rupc/synthesizer/README.md

## 동기
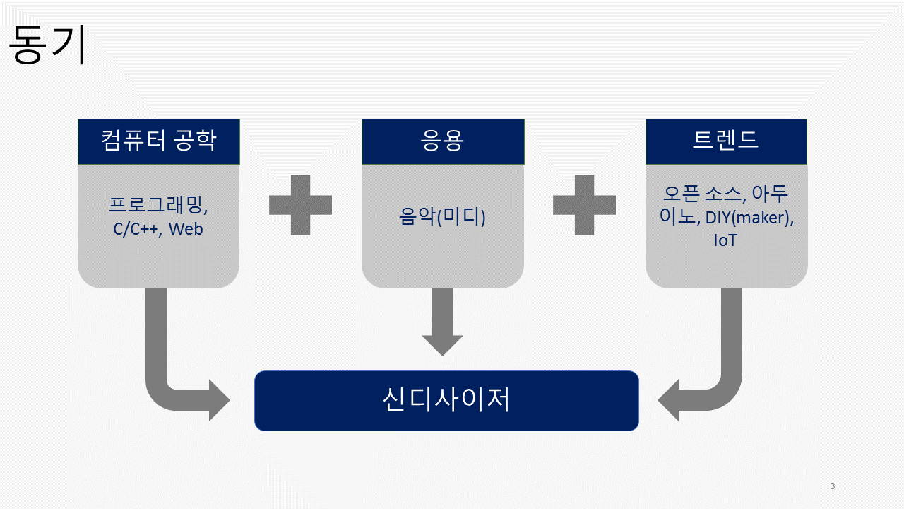
[picture p1: pics/slide3.PNG]


## 시스템 구성
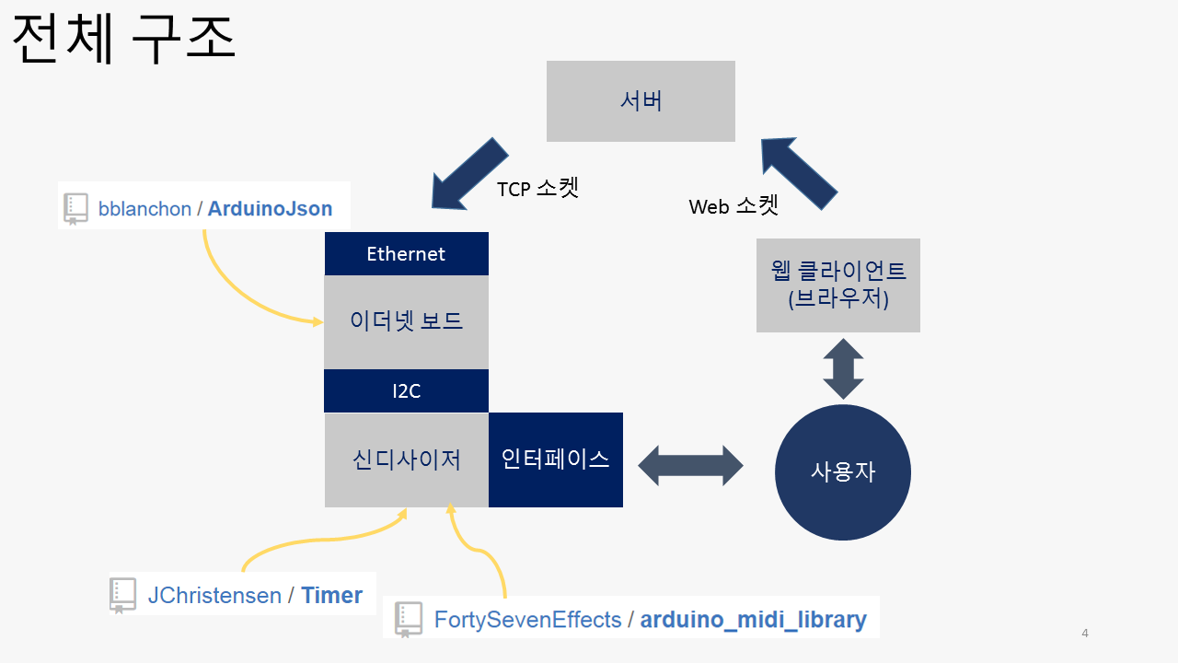
[picture p2: pics/슬라이드4.PNG]


## 신다사이저의 구성
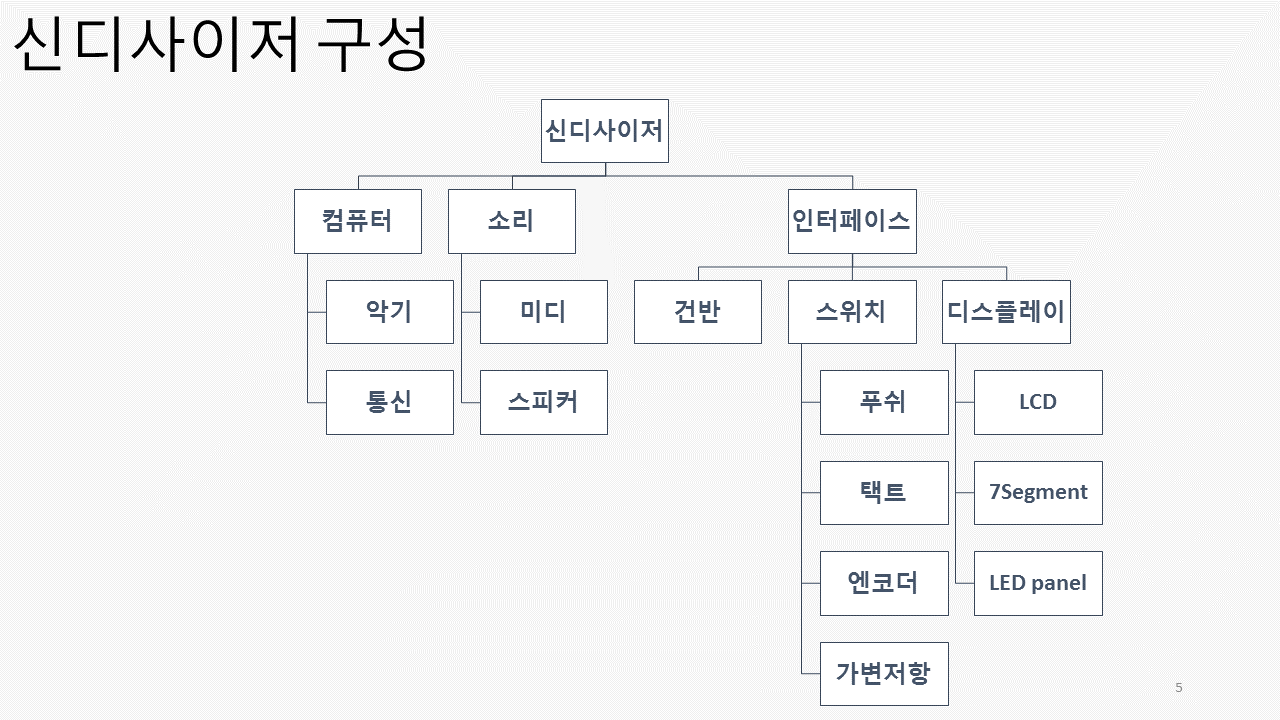
[picture p3: pics/슬라이드5.PNG]


## 기술 세부사항
### 하드웨어
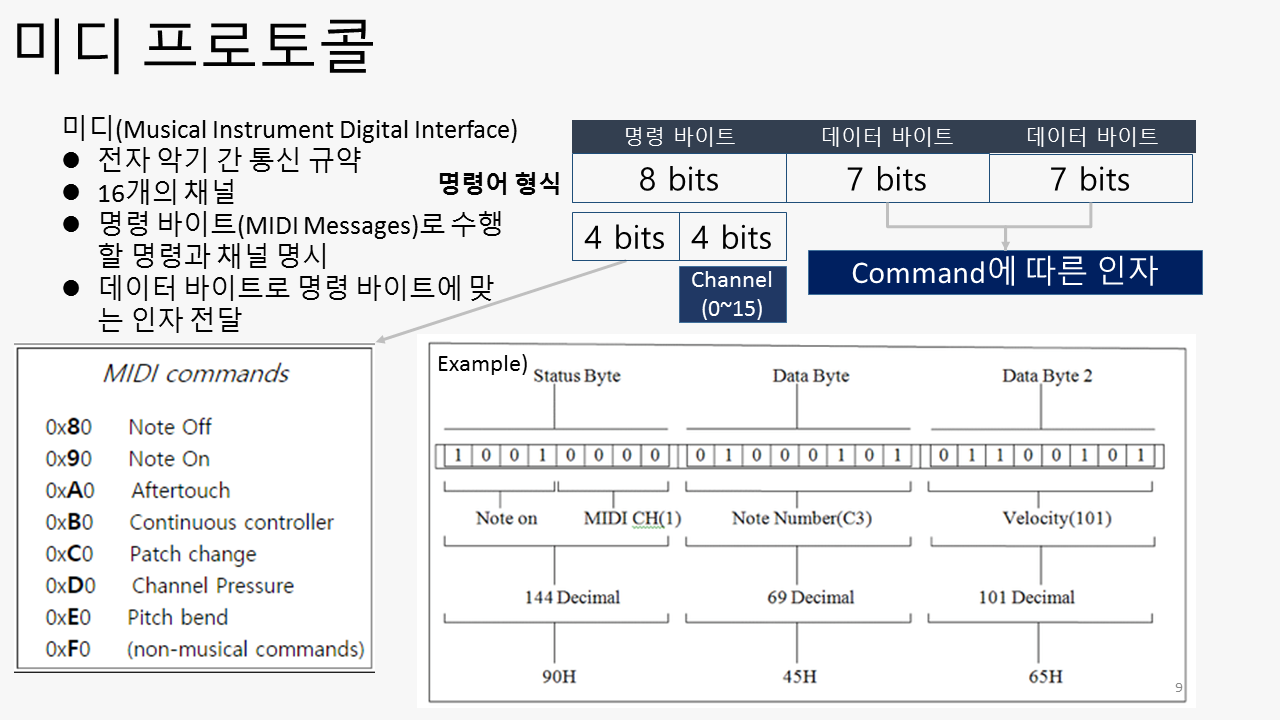
[picture p4: pics/슬라이드9.PNG]

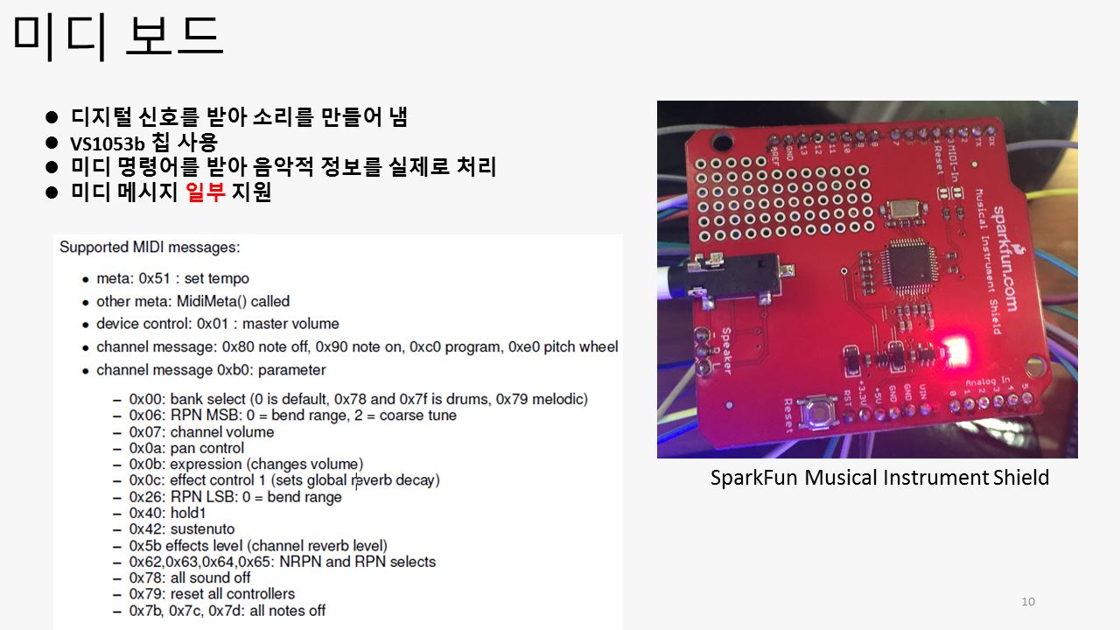
[picture p5: pics/슬라이드10.PNG]

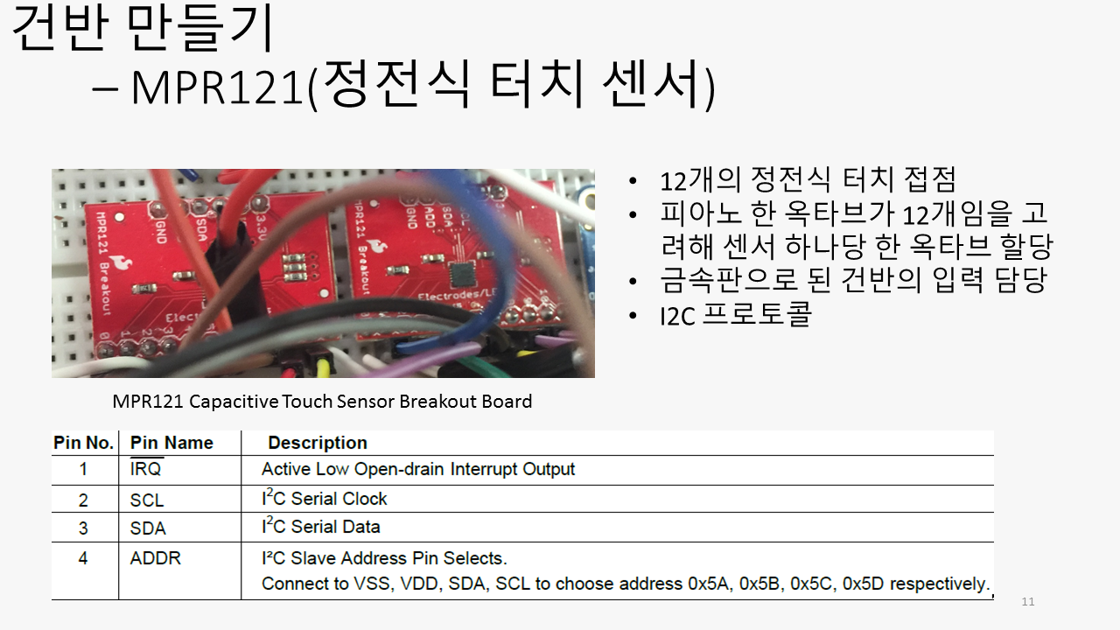
[picture p6: pics/슬라이드11.PNG]

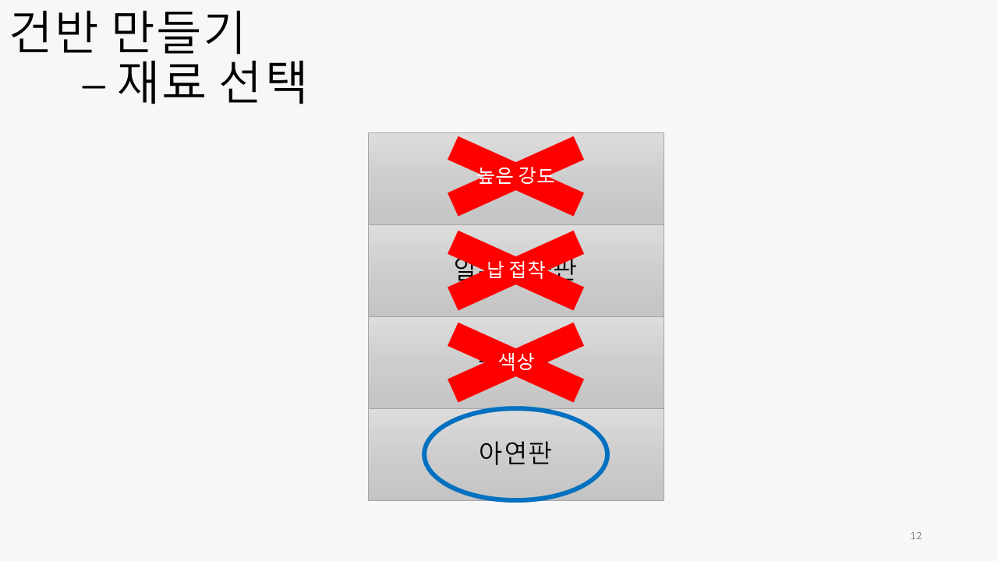
[picture p7: pics/슬라이드12.PNG]

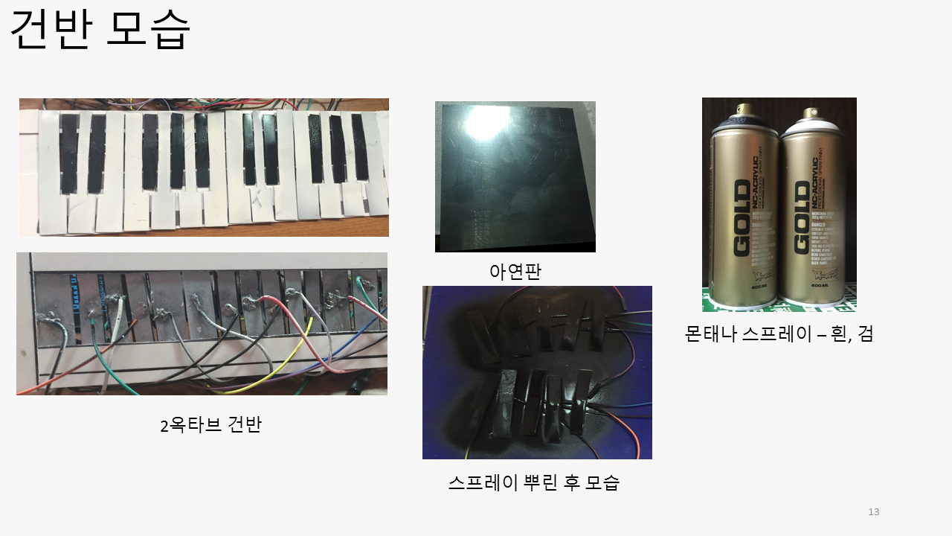
[picture p8: pics/슬라이드13.PNG]

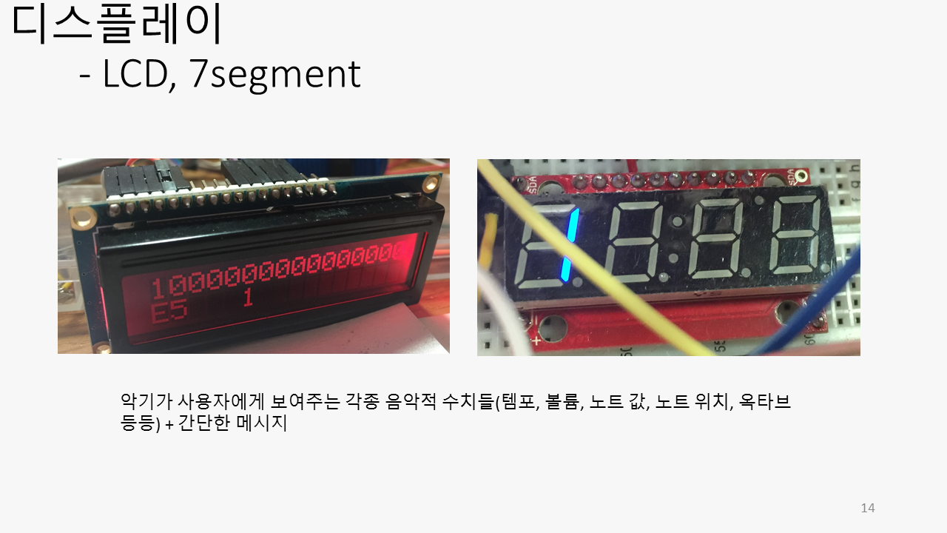
[picture p9: pics/슬라이드14.PNG]

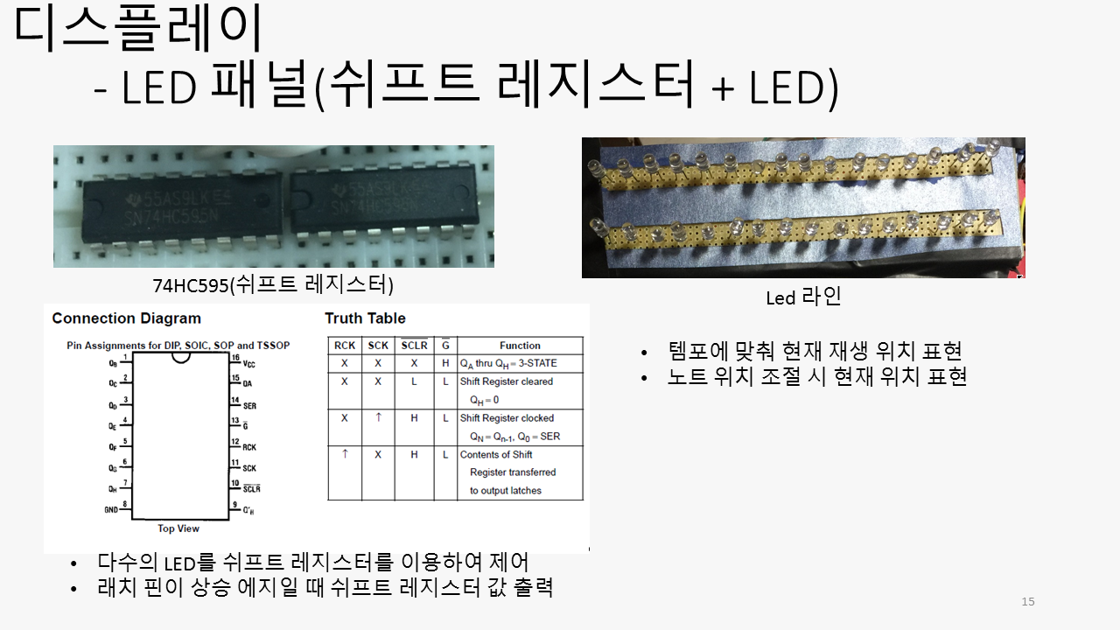
[picture p10: pics/슬라이드15.PNG]

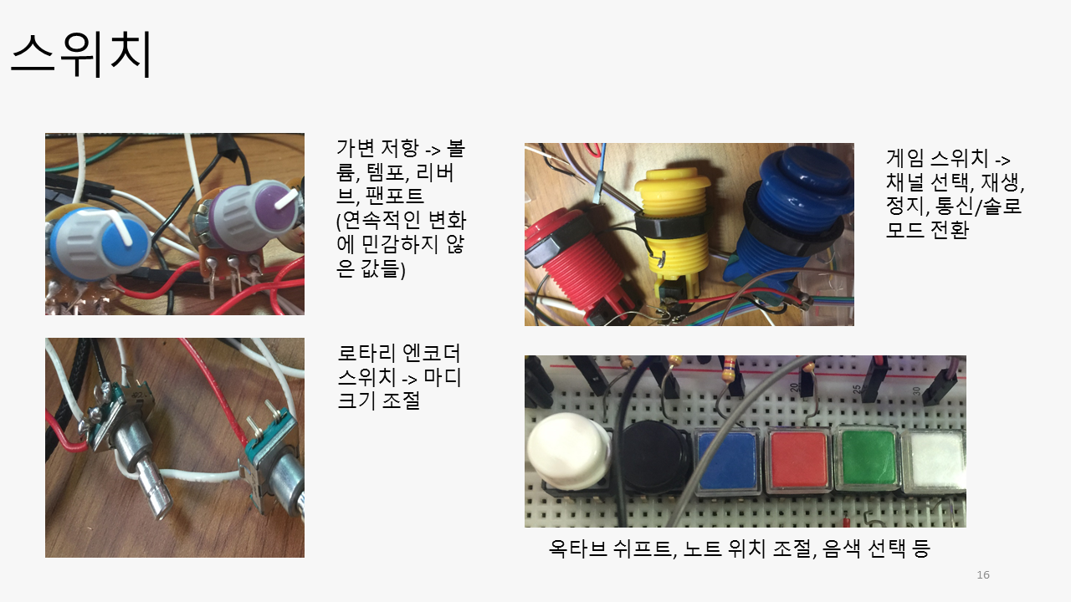
[picture p11: pics/슬라이드16.PNG]

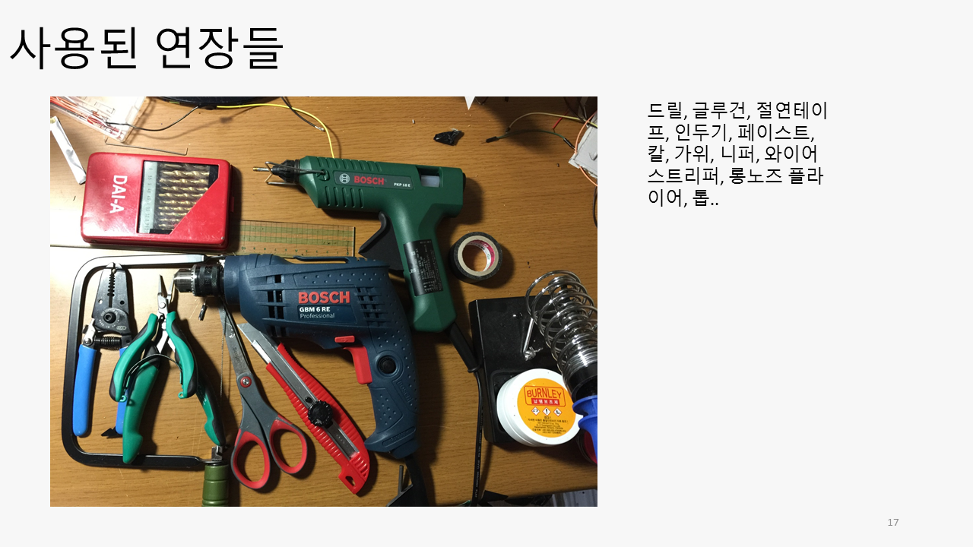
[picture p12: pics/슬라이드17.PNG]


### 소프트웨어
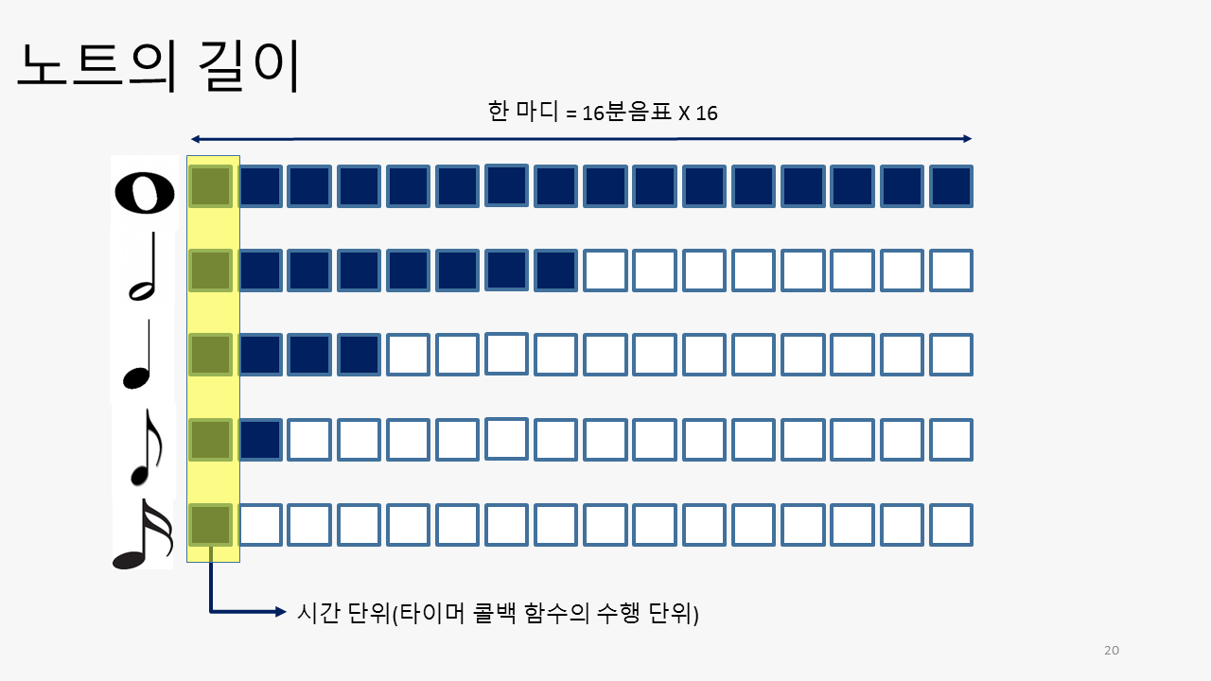
[picture p13: pics/슬라이드20.PNG]

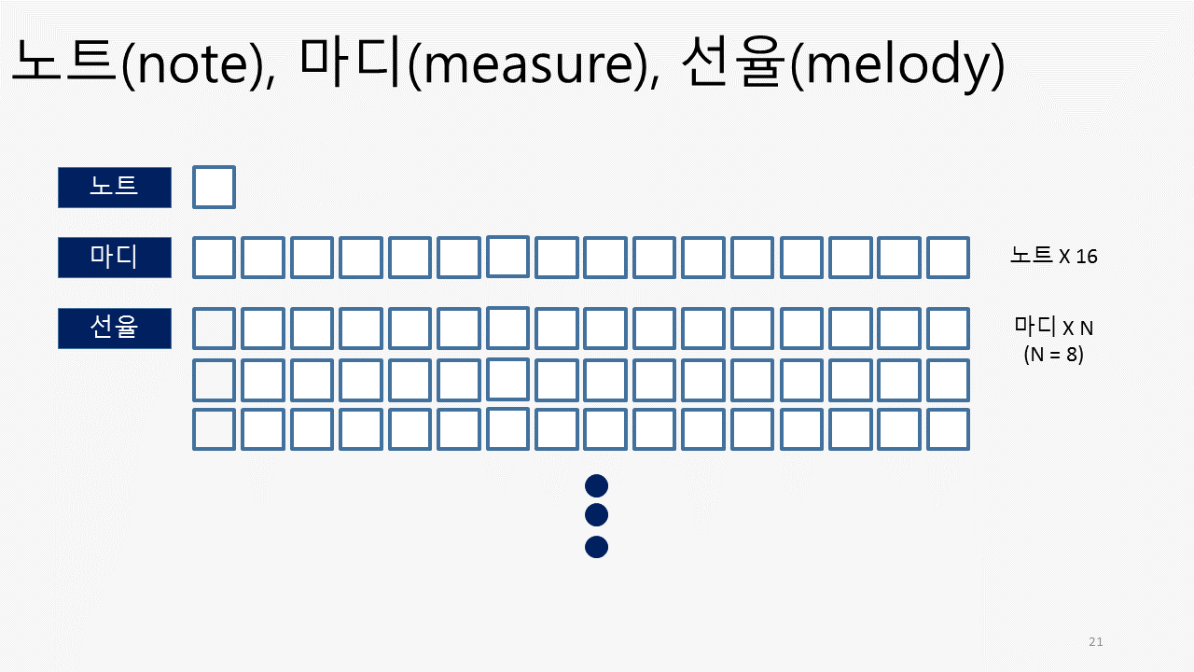
[picture p14: pics/슬라이드21.PNG]

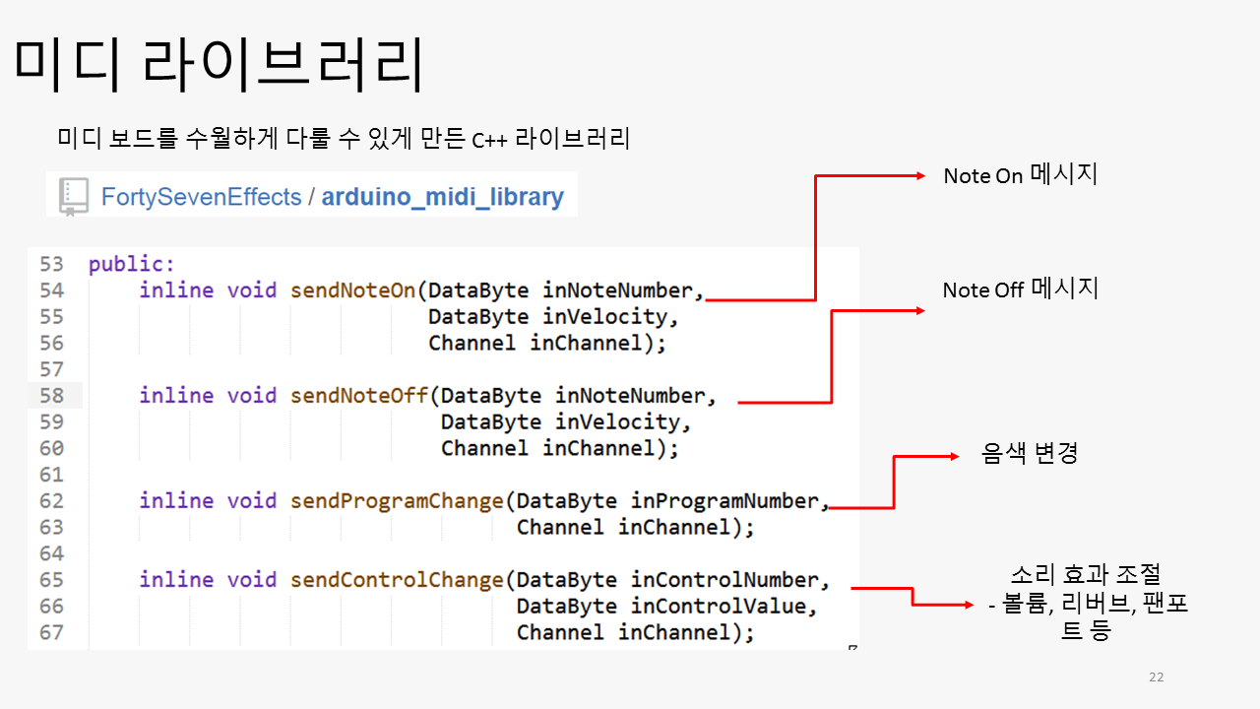
[picture p15: pics/슬라이드22.PNG]

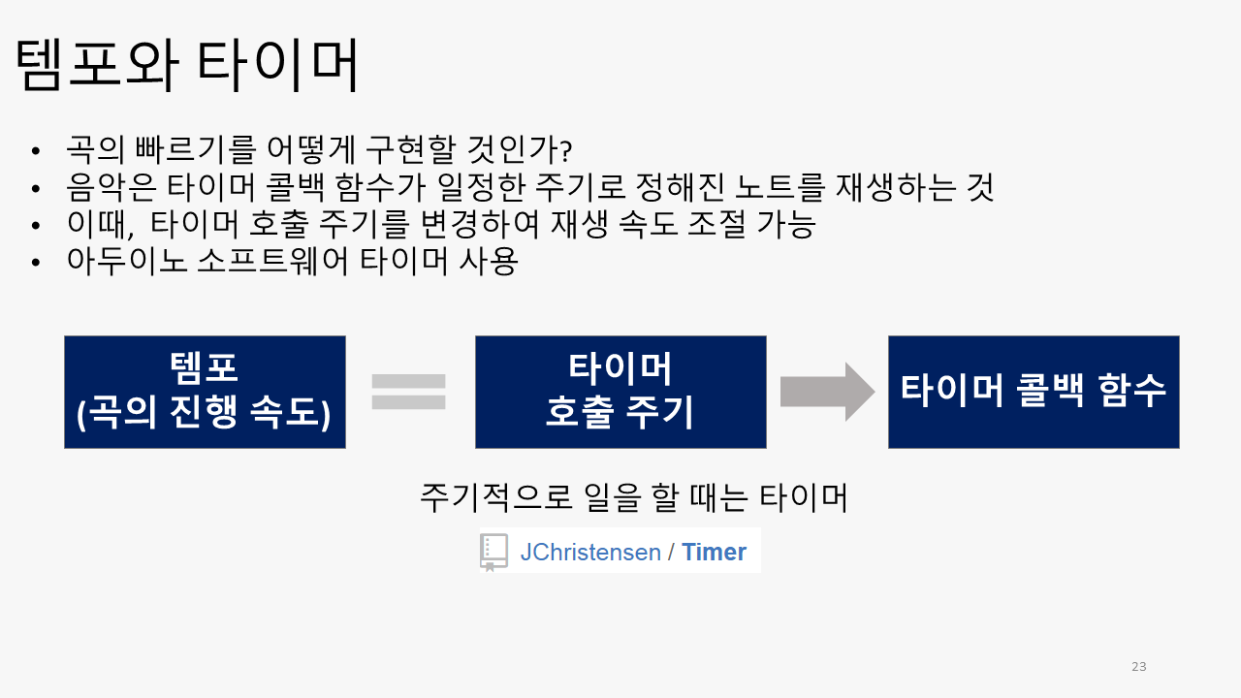
[picture p16: pics/슬라이드23.PNG]

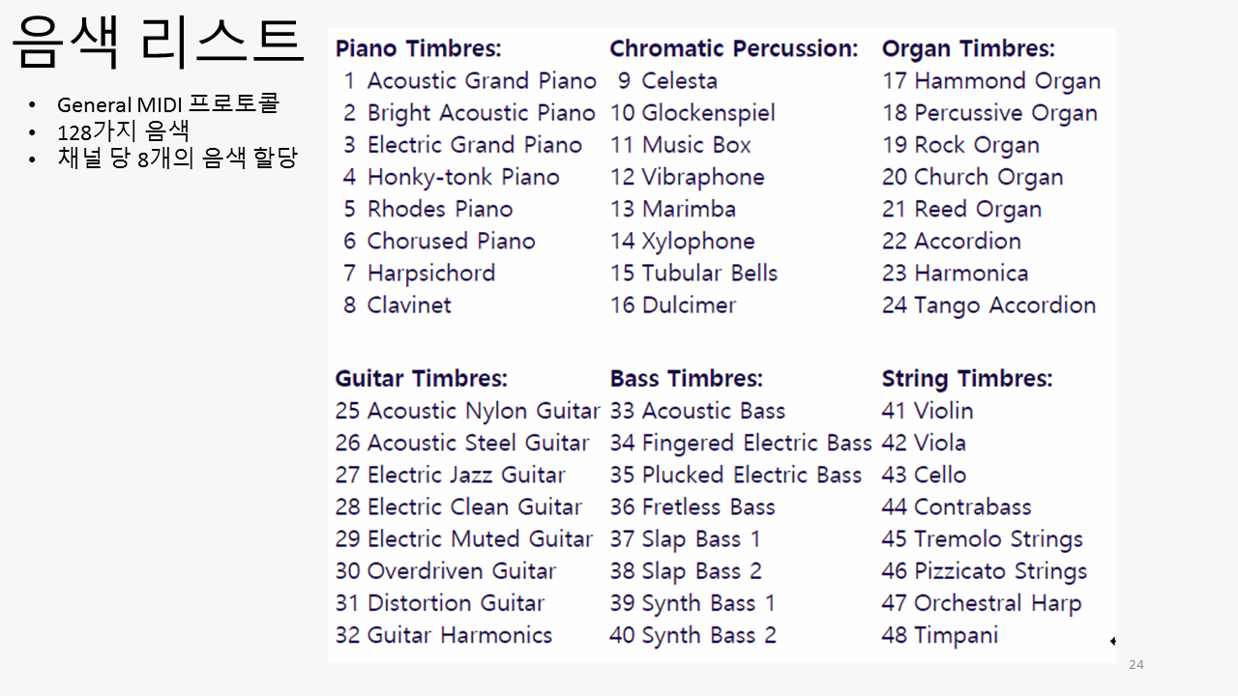
[picture p17: pics/슬라이드24.PNG]

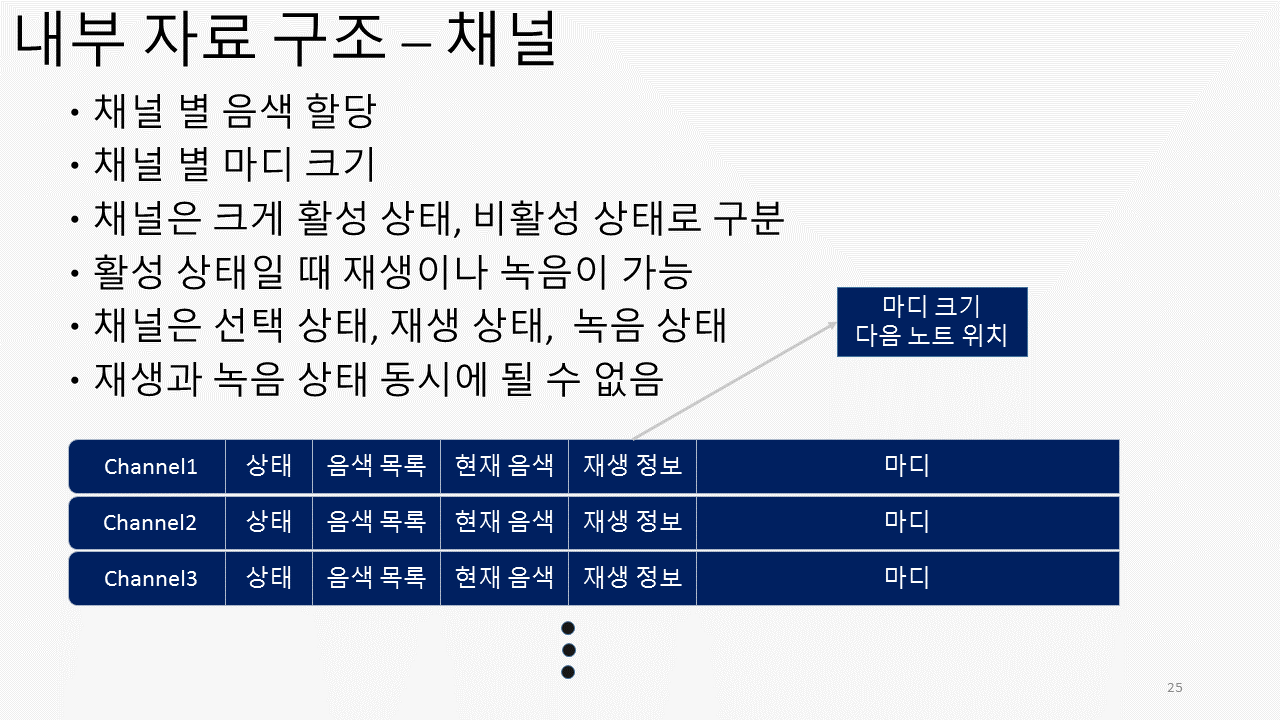
[picture p18: pics/슬라이드25.PNG]

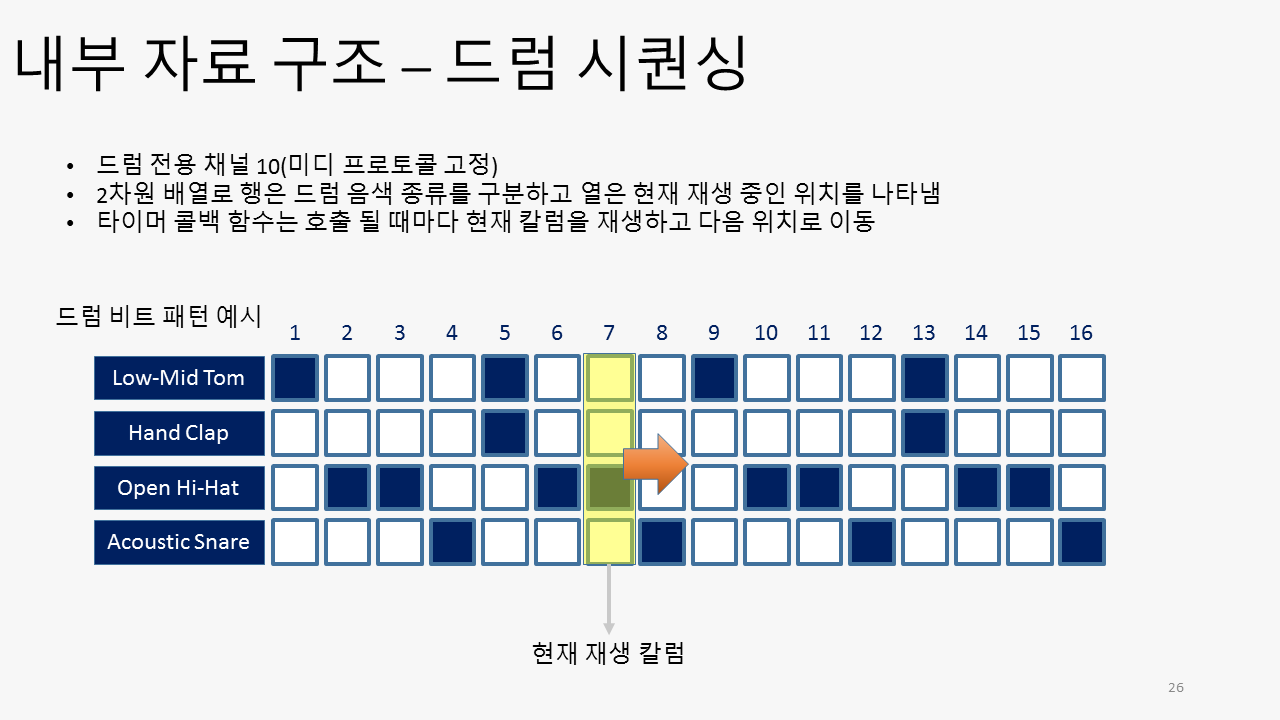
[picture p19: pics/슬라이드26.PNG]


### 기능
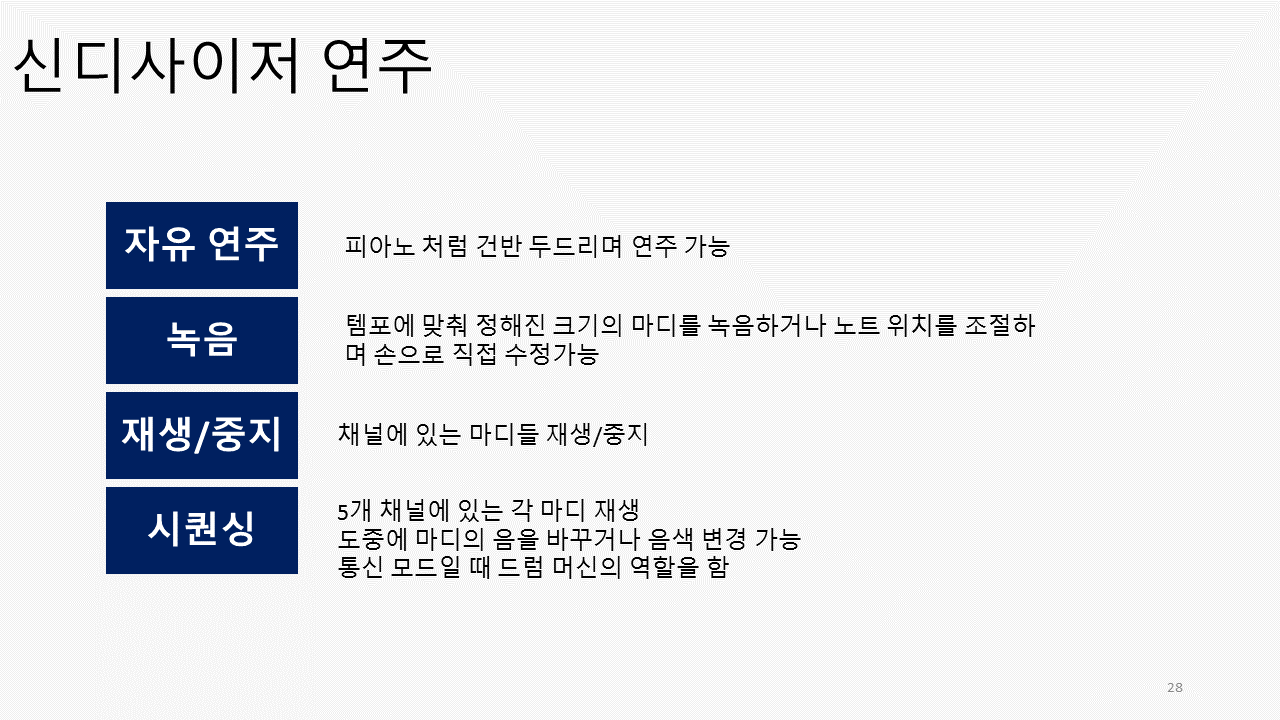
[picture p20: pics/슬라이드28.PNG]

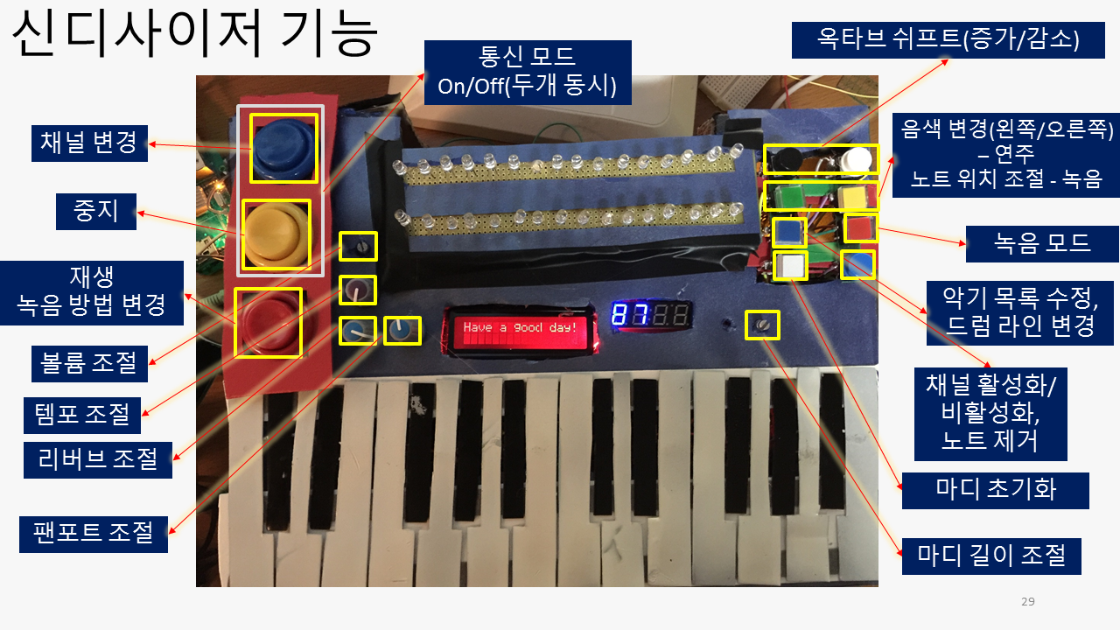
[picture p21: pics/슬라이드29.PNG]


## 영상
[기본 연주](https://www.youtube.com/watch?v=AMejLA61EGs)
[웹 기반 연주](https://www.youtube.com/watch?v=s74J_ezt0MM)
