rupc/synthesizer/docs/2015졸업과제-발표자료(하프시코드).pdf

# 신디사이저와 IoT

### 하프시코드 201224540 조용래

목차

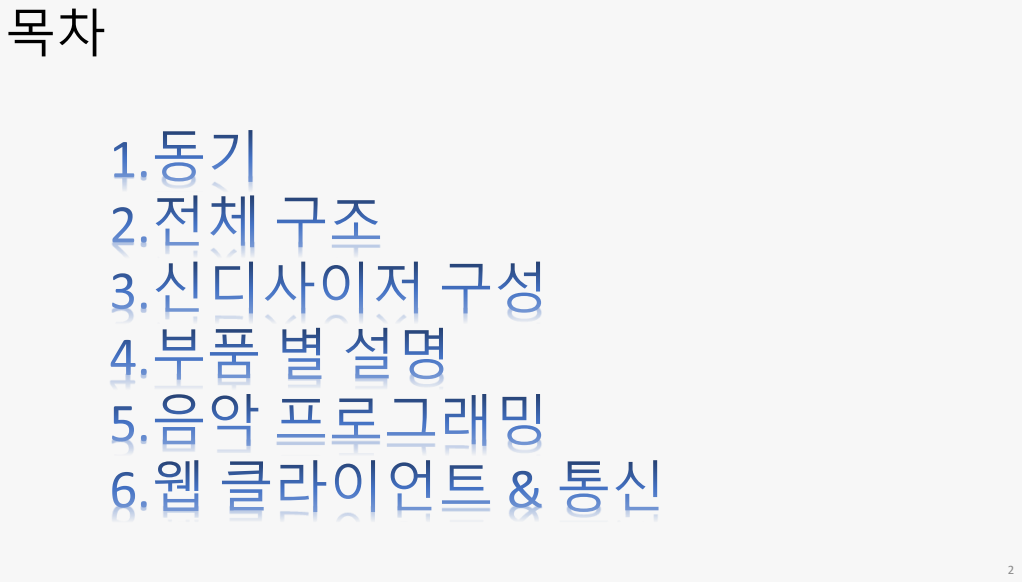
[picture p55: page 2]

동기

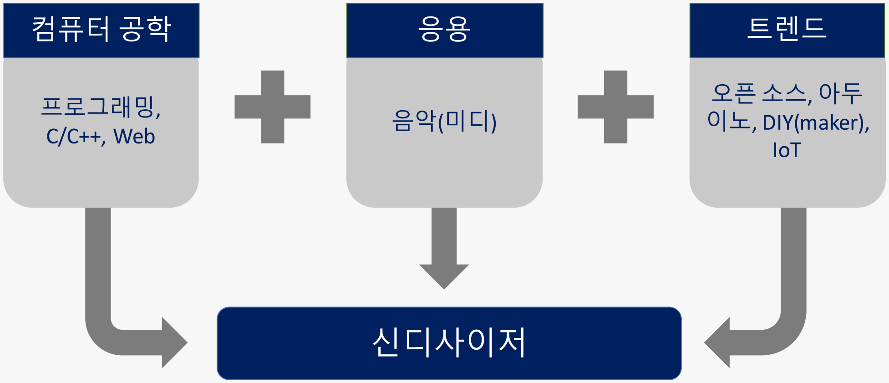
[picture p56: figure]
프로그래밍, C/C++, Web; 컴퓨터 공학; 오픈 소스, 아두 이노, DIY(maker), IoT; 트렌드; 신디사이저

# 전체 구조

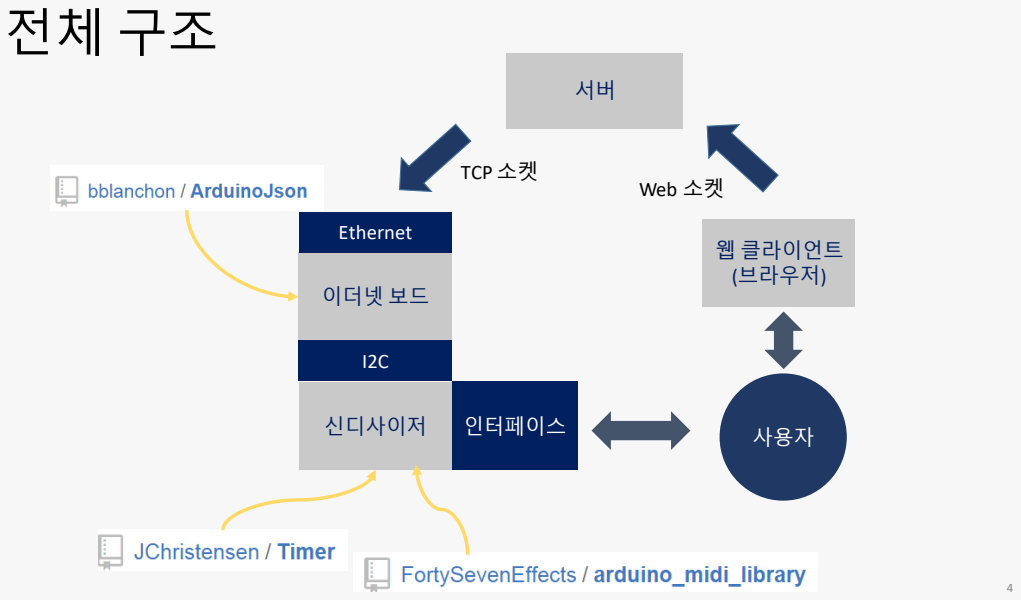
[picture p57: page 4]
TCP 소켓; Web 소켓; 웹 클라이언트 (브라우저); 이더넷 보드; 신디사이저; 인터페이스; 사용자; Ethernet

# 신디사이저 구성

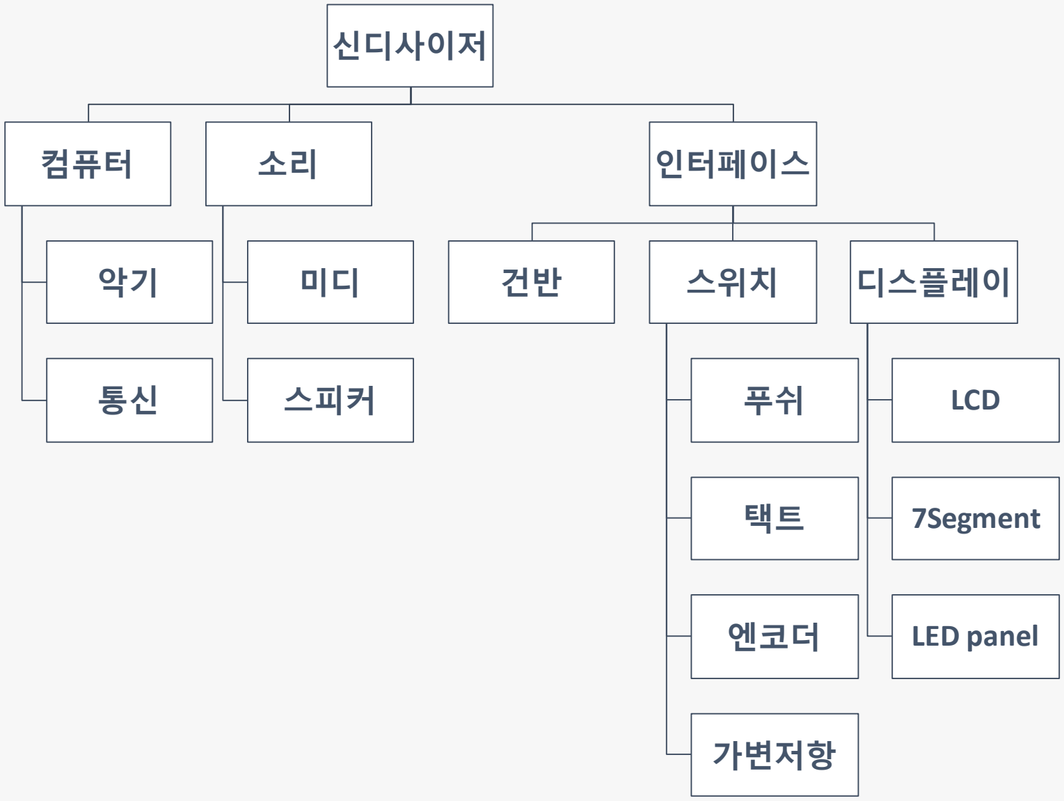
[picture p58: figure]
신디사이저; 컴퓨터; 스피커; 인터페이스; 스위치; 엔코더; 가변저항; 디스플레이; LCD; 7Segment; LED panel

# 신디사이저 전체 사진

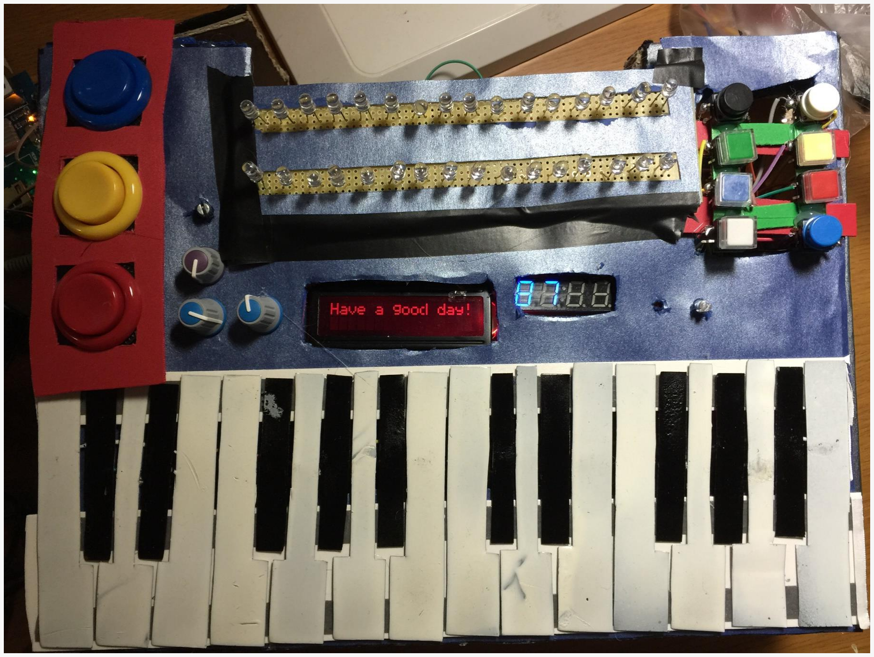
[picture p59: figure]

# 부품 별 설명

# 마이크로컨트롤러

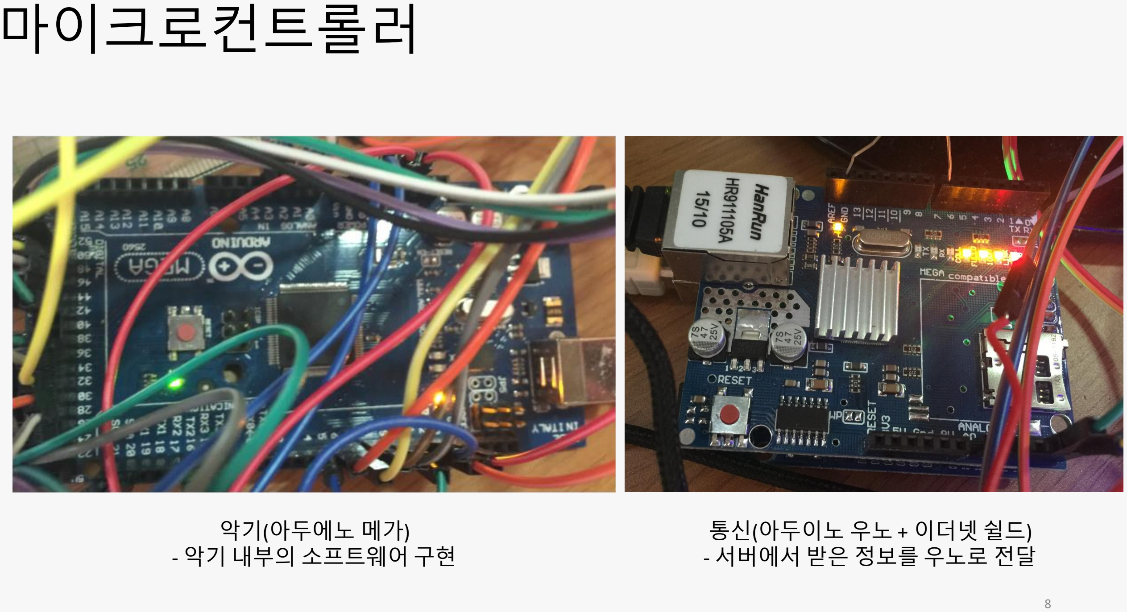
[picture p60: page 8]

통신(아두이노 우노 + 이더넷 쉴드)
- 서버에서 받은 정보를 우노로 전달

악기(아두에노 메가)
- 악기 내부의 소프트웨어 구현

# 미디 프로토콜

8 bits | 7 bits | 7 bits

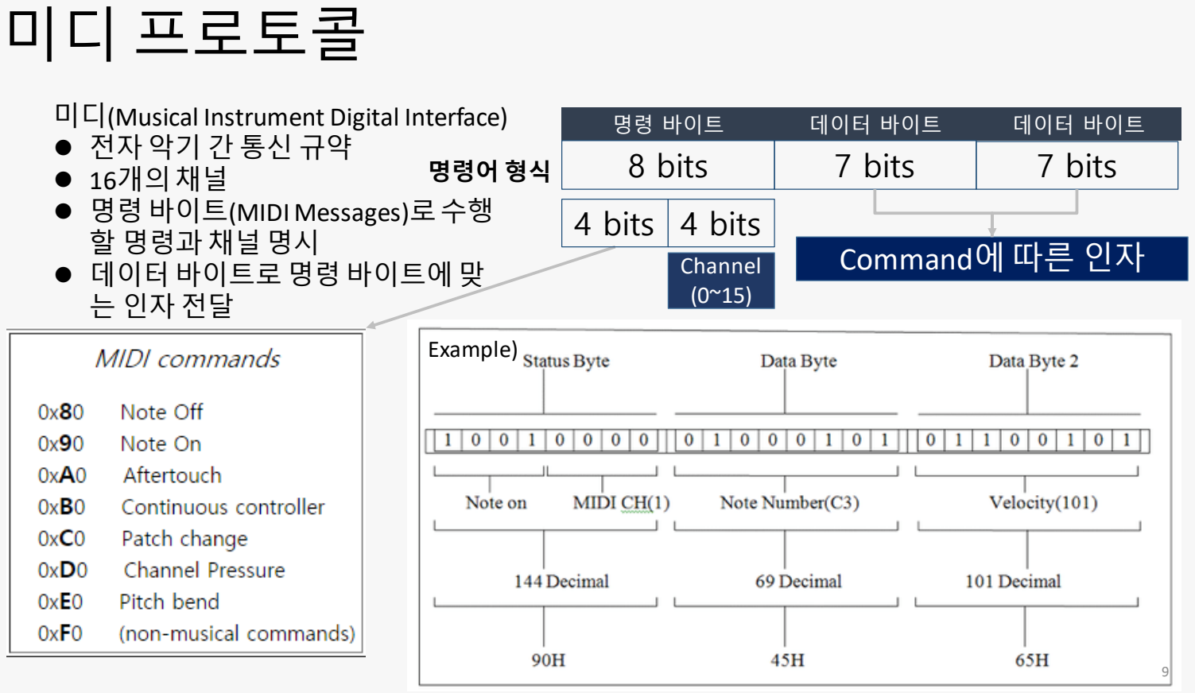
[picture p61: page 9]

미디(Musical Instrument Digital Interface)
- 전자 악기 간 통신 규약
- 16개의채널
- 명령 바이트(MIDI Messages)로수행 할 명령과 채널 명시
- 데이터 바이트로 명령 바이트에 맞
는 인자 전달

명령어 형식

명령 바이트 | 데이터 바이트 | 데이터 바이트
4 bits | 4 bits Channel (0~15)

### Command에 따른 인자

Example)

# 미디 보드

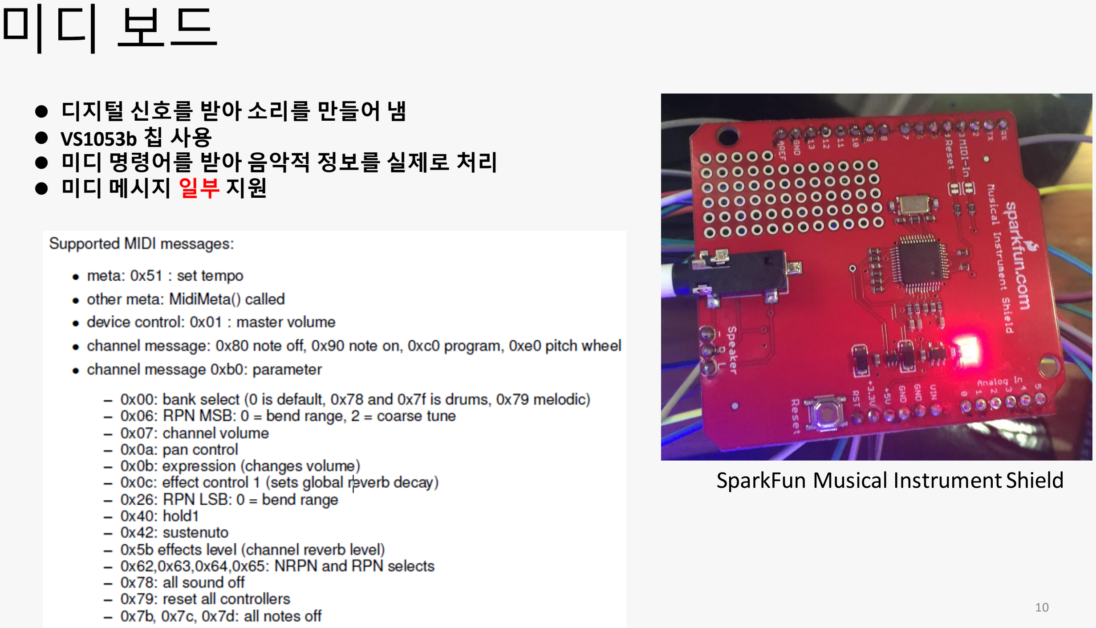
[picture p62: page 10]

- 디지털 신호를 받아 소리를 만들어 냄
- VS1053b 칩 사용
- 미디 명령어를 받아 음악적 정보를 실제로 처리
- 미디 메시지 일부 지원

SparkFun Musical Instrument Shield

# 건반 만들기

# – MPR121(정전식 터치 센서)

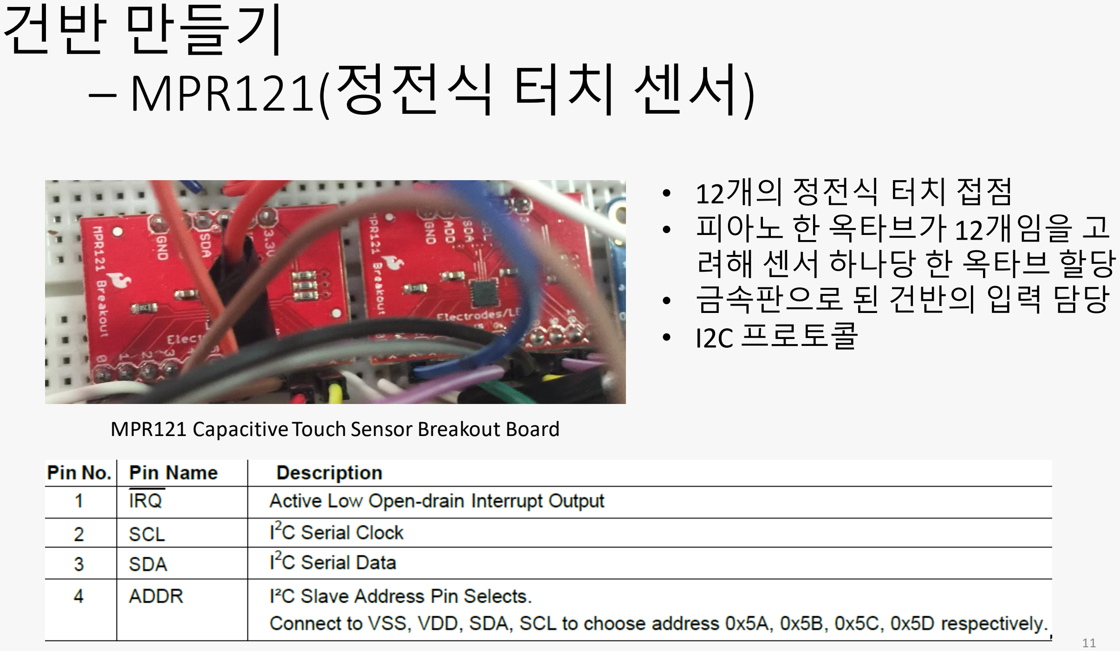
[picture p63: page 11]

## - 12개의 정전식 터치 접점 - 피아노 한 옥타브가 12개임을 고 려해 센서 하나당 한 옥타브 할당 - 금속판으로 된 건반의 입력 담당

### - I2C 프로토콜

MPR121 Capacitive Touch Sensor Breakout Board

# 건반 만들기 – 재료 선택

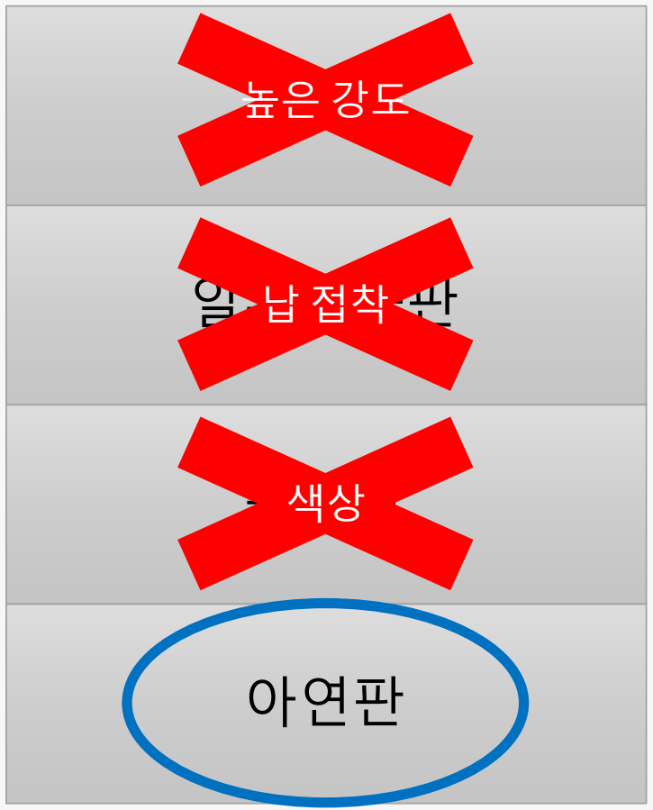
[picture p64: figure]
알루미늄판; 구리판; 아연판

# 건반 모습

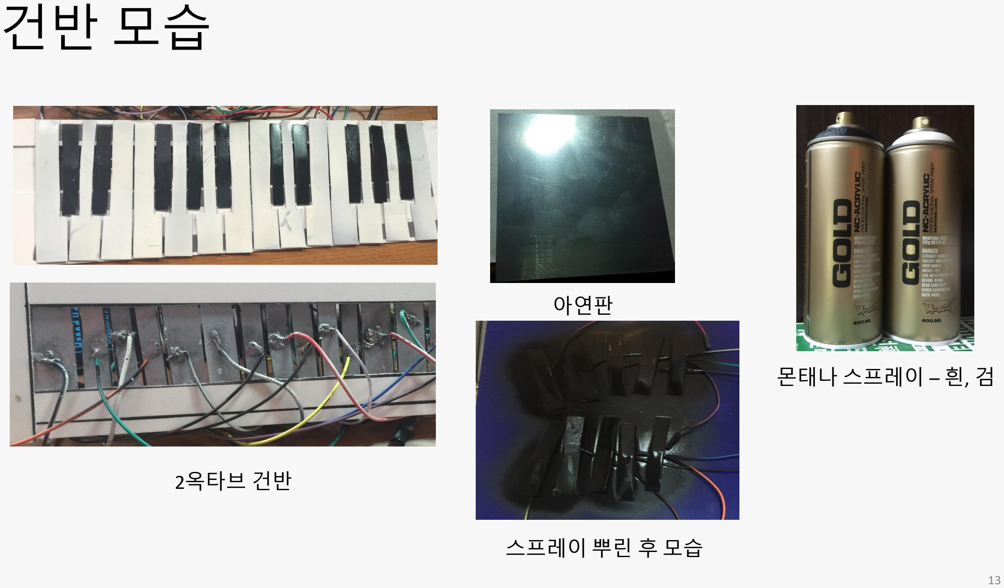
[picture p65: page 13]

몬태나 스프레이 – 흰, 검

아연판

2옥타브 건반

스프레이 뿌린 후 모습

# 디스플레이

# - LCD, 7segment

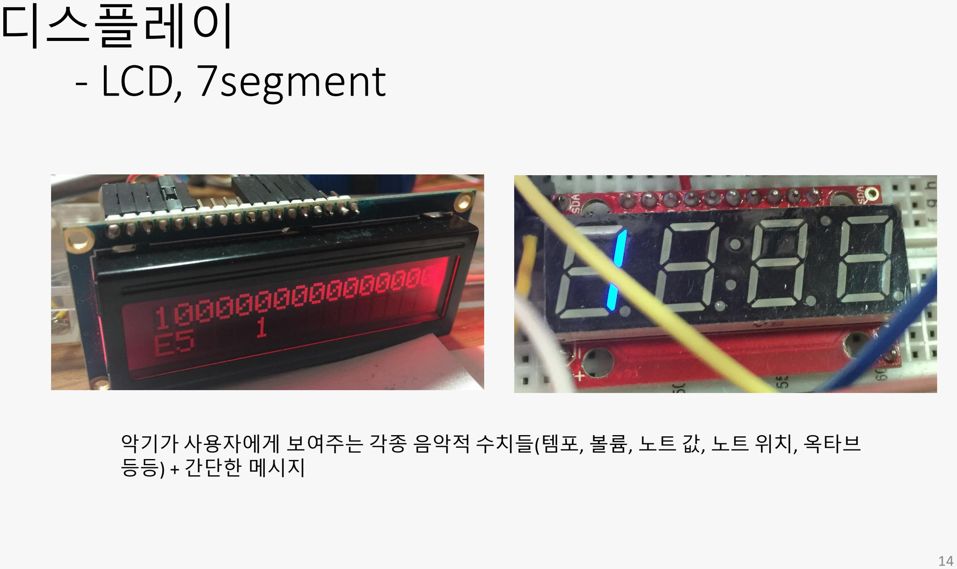
[picture p66: page 14]

악기가 사용자에게 보여주는 각종 음악적 수치들(템포, 볼륨, 노트 값, 노트 위치, 옥타브 등등) + 간단한 메시지

# 디스플레이

# - LED 패널(쉬프트 레지스터 + LED)

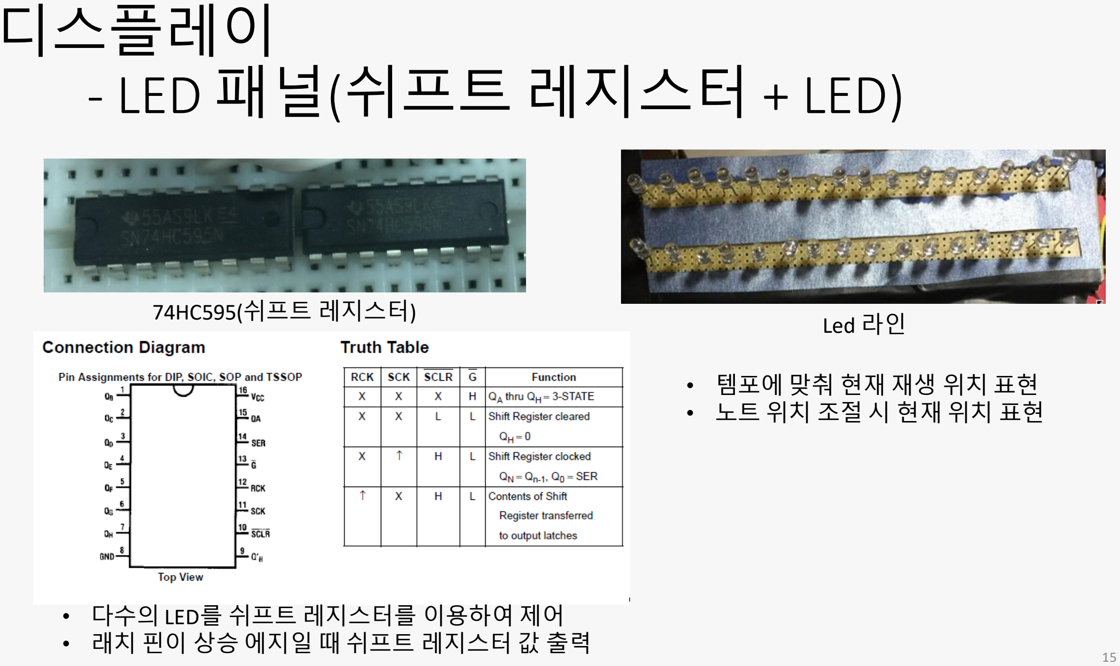
[picture p67: page 15]

- 다수의 LED를 쉬프트 레지스터를 이용하여 제어
- 래치 핀이 상승 에지일 때 쉬프트 레지스터 값 출력
- 템포에 맞춰 현재 재생 위치 표현
- 노트 위치 조절 시 현재 위치 표현

74HC595(쉬프트 레지스터)
Led 라인

# 스위치

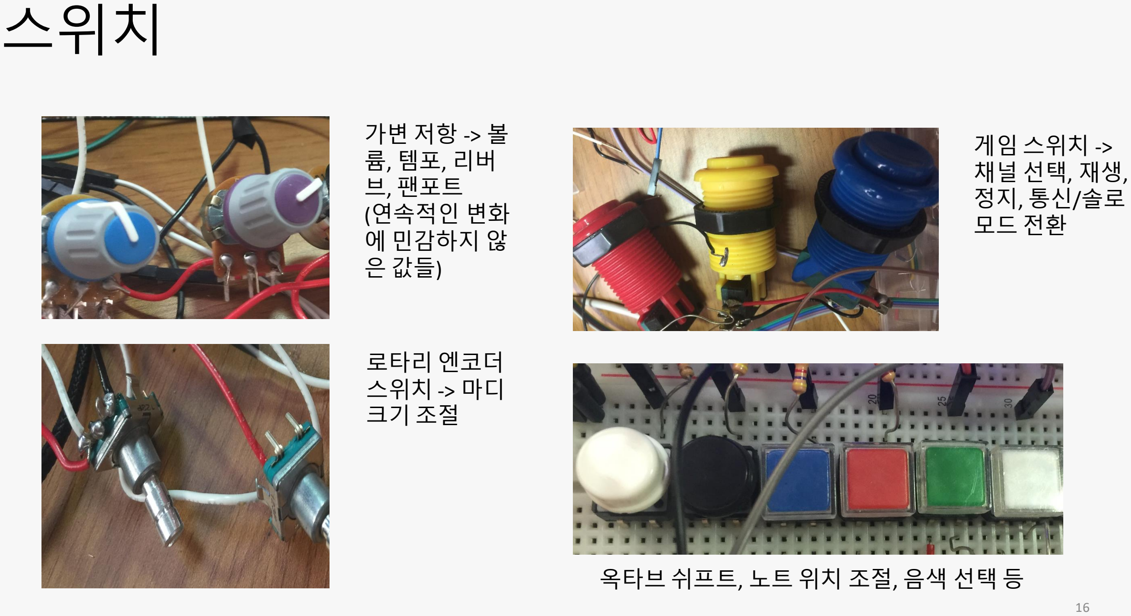
[picture p68: page 16]

가변 저항 -> 볼
륨, 템포, 리버
브, 팬포트
(연속적인 변화
에 민감하지 않
은 값들)

게임 스위치 ->
채널 선택, 재생,
정지, 통신/솔로
모드 전환

로타리 엔코더
스위치 -> 마디
크기 조절

옥타브 쉬프트, 노트 위치 조절, 음색 선택 등

# 사용된 연장들

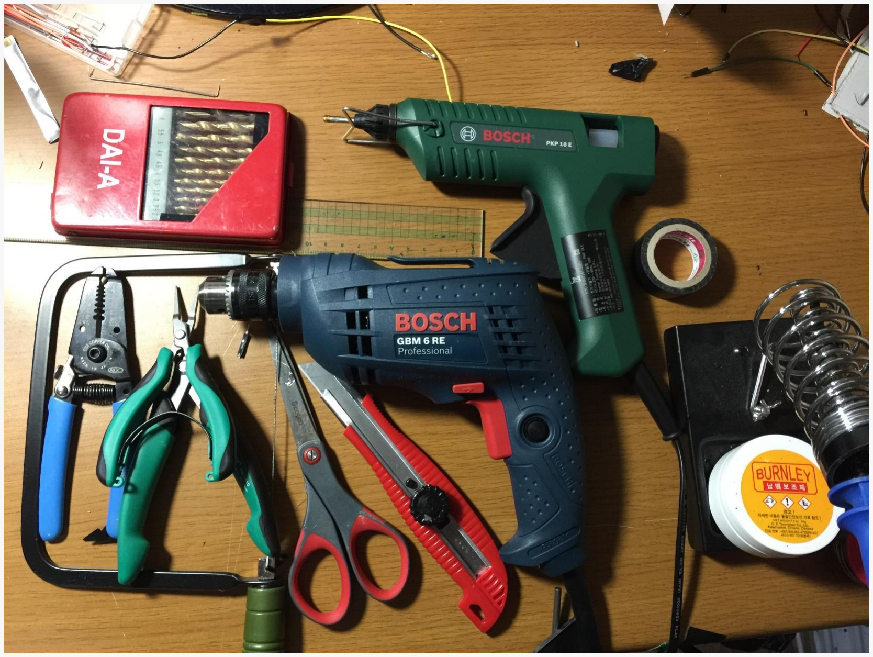
[picture p69: figure]

드릴, 글루건, 절연테이
프, 인두기, 페이스트,
칼, 가위, 니퍼, 와이어
스트리퍼, 롱노즈 플라
이어, 톱..

# 건반 시연 영상 (https://youtu.be/AMejLA61EGs)

# 음악 프로그래밍

음악을 프로그래밍 하려면?

# 노트의 길이

시간 단위(타이머 콜백 함수의 수행 단위)

한 마디 = 16분음표 X 16

# 노트(note), 마디(measure), 선율(melody)

마디

노트

선율

노트 X 16

마디 X N
(N = 8)

# 미디 라이브러리

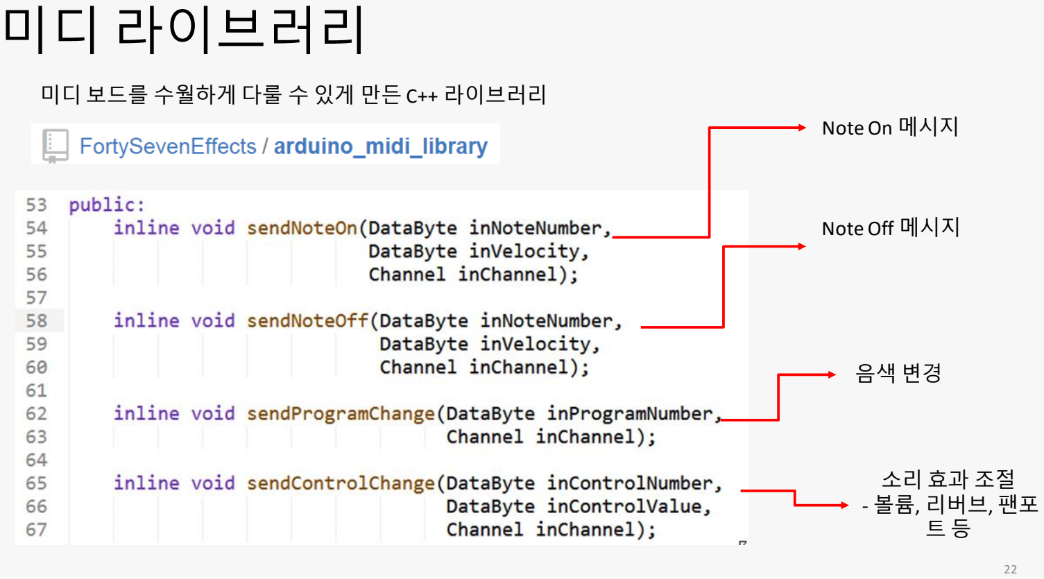
[picture p70: page 22]

Note On 메시지

Note Off 메시지

음색 변경

소리 효과 조절
- 볼륨, 리버브, 팬포
트 등

미디 보드를 수월하게 다룰 수 있게 만든 C++ 라이브러리

# 템포와 타이머

템포

## (곡의 진행 속도)

## 타이머

호출 주기 | 타이머 콜백 함수

## - 곡의 빠르기를 어떻게 구현할 것인가? - 음악은 타이머 콜백 함수가 일정한 주기로 정해진 노트를 재생하는 것 - 이때, 타이머 호출 주기를 변경하여 재생 속도 조절 가능 - 아두이노 소프트웨어 타이머 사용

## 주기적으로 일을 할 때는 타이머


# 음색 리스트

- General MIDI 프로토콜
- 128가지 음색
- 채널 당 8개의 음색 할당

# 내부 자료 구조 – 채널

## - 채널 별 음색 할당 - 채널 별 마디 크기 - 채널은 크게 활성 상태, 비활성 상태로 구분 - 활성 상태일 때 재생이나 녹음이 가능

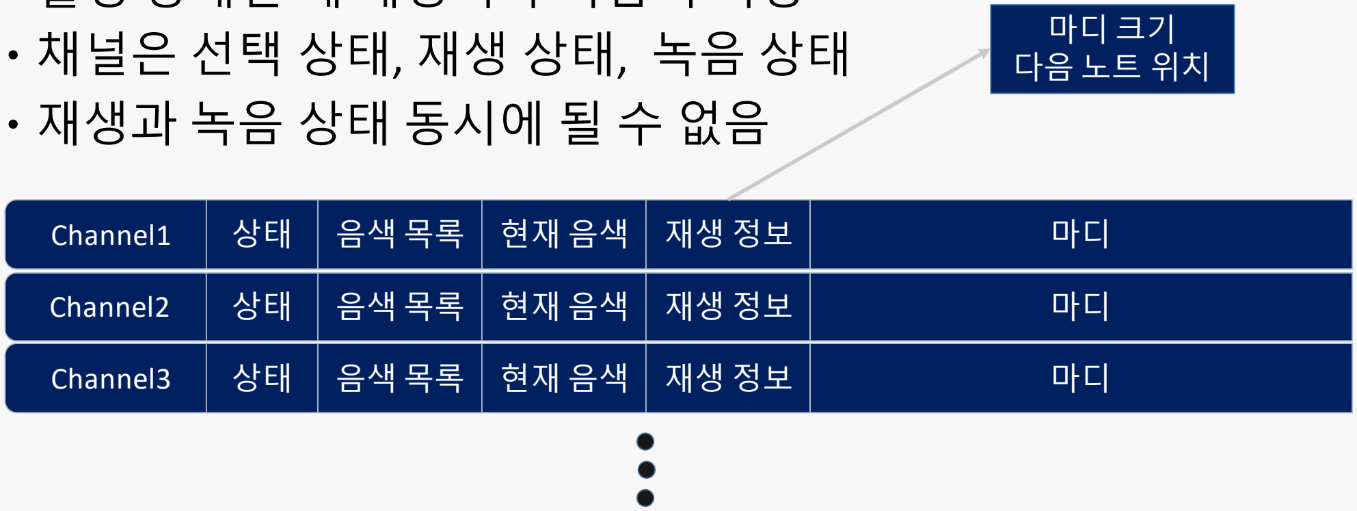
[picture p71: figure]
채널은 선택 상태, 재생 상태, 녹음 상태 재생과 녹음 상태 동시에 될 수 없음; Channel1; Channel2; Channel3

# 내부 자료 구조 – 드럼 시퀀싱

1 | 2 | 3 | 4 | 5 | 6 | 7 | 8 | 9 | 10 11 12 13 14 15 16

Low-Mid Tom

Hand Clap

Open Hi-Hat

Acoustic Snare

현재 재생 칼럼

- 드럼 전용 채널 10(미디 프로토콜 고정)
- 2차원 배열로 행은 드럼 음색 종류를 구분하고 열은 현재 재생 중인 위치를 나타냄
- 타이머 콜백 함수는 호출 될 때마다 현재 칼럼을 재생하고 다음 위치로 이동

드럼 비트 패턴 예시

# 드럼 시퀀싱 시연 영상 (https://youtu.be/Qu10QJPF3bk)

# 신디사이저 연주

녹음

## 시퀀싱

## 자유 연주

## 재생/중지

피아노 처럼 건반 두드리며 연주 가능

템포에 맞춰 정해진 크기의 마디를 녹음하거나 노트 위치를 조절하 며 손으로 직접 수정가능

채널에 있는 마디들 재생/중지

5개 채널에 있는 각 마디 재생
도중에 마디의 음을 바꾸거나 음색 변경 가능
통신 모드일 때 드럼 머신의 역할을 함

신디사이저 기능 | 옥타브 쉬프트

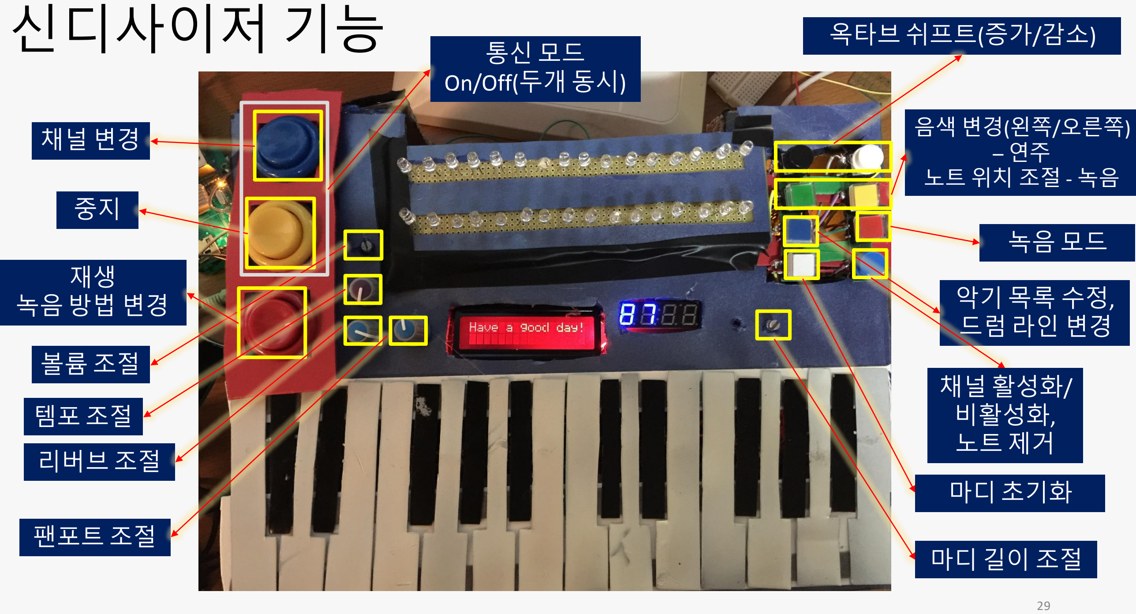
[picture p72: page 29]

(증가

/감소
)

음색 변경

(왼쪽
/오른쪽)
– 연주
노트 위치 조절
- 녹음

악기 목록 수정
,
드럼 라인 변경

녹음 모드

채널 변경

중지

볼륨 조절

재생
녹음 방법 변경

템포 조절

통신 모드
On/Off(두개 동시
)

리버브 조절

팬포트 조절

채널 활성화
/
비활성화
,
노트 제거

마디 초기화

마디 길이 조절

# 몇가지 난점들 – 건반 갯수

## 부족한 건반 갯수

## (24개-2옥타브)

## 옥타브 쉬프트

## (최소 옥타브 조절)

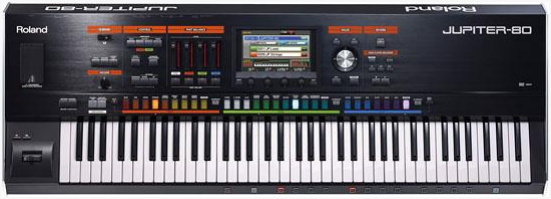
[picture p73: figure]

### Roland - JUPITER-50

보통 48~88개의 건반

# 몇가지 난점들 – 버튼 갯수

## 종류/기능에 따른

## 별개 버튼 할당

## 핀 부족/배선 부담

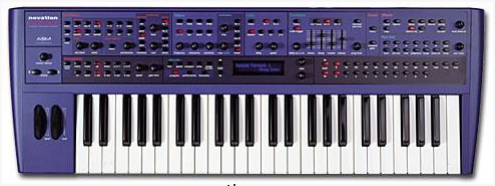
[picture p74: figure]

### novation - nova

## 상황에 따른 서로 다른 기능

# 웹 클라이언트 & 통신


- HTML5, CSS3, Canvas, Javascript, Jquery 활용
- 웹 소켓 방식으로 값 변화시 실시간 전송
- 원격 16스텝 드럼 시퀀서 구현
- 드럼 라인과 드럼 음색을 선택 후 원하는 위 치를 클릭하면 악기 쪽으로 재생 정보 전달
- 볼륨, 리버브, 팬 포트는 값 변화시(슬라이더 움직이는 도중) 즉시 악기에 반영
- 나머지는 슬라이더움직임이 끝난 후 반영
(통신 부하를 줄이기 위함)

# 브라우저에서 악기 연주 하기

# 웹 기반 드럼 머신 연주 (https://youtu.be/s74J_ezt0MM)

# 통신 흐름

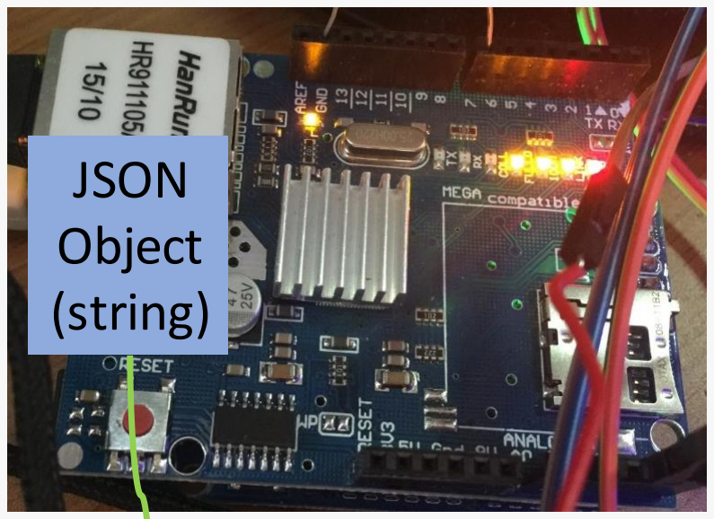
[picture p75: figure]
JSON Object (string)

### 파싱된 JSON Object {name, value}

소켓 이벤트
방출
웹 소켓 | TCP 소켓

I2C

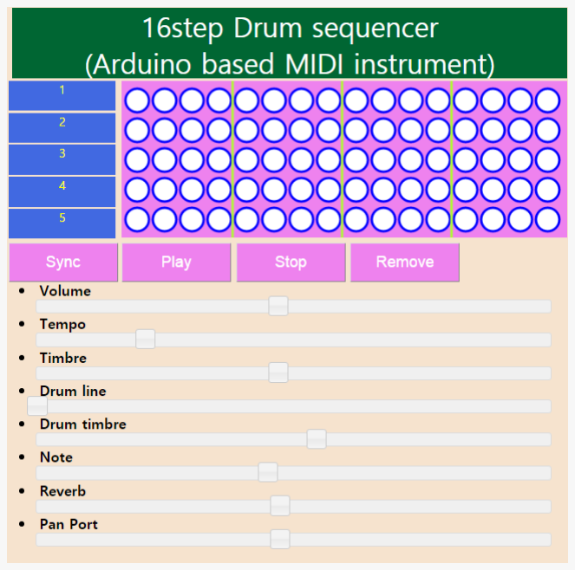
[picture p76: figure]
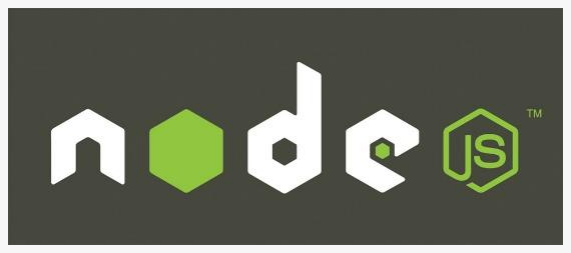
[picture p77: figure]

브라우저 | 이더넷 보드

서버

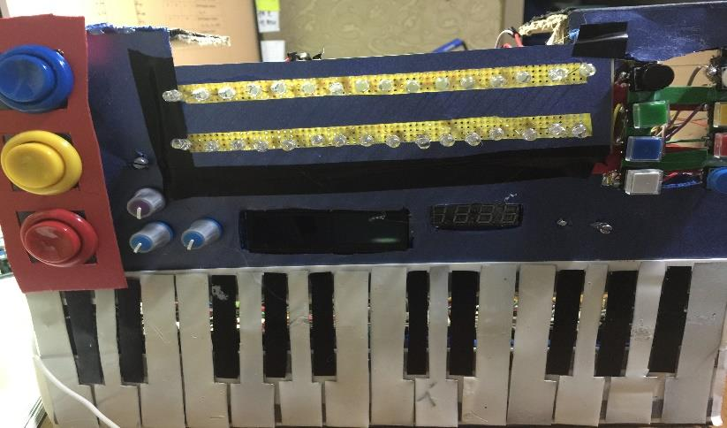
[picture p78: figure]

악기

# 덧붙임

# 사물들의 소유주의 필요와 이익에 근거하여 점차적으로 인터넷에 연결

### IoT의 정의?

# 어느 정도 인지도 있는 오픈 소스만 표기

### ->이외에도 MPR121 관련 레지스터 세팅하고 읽고 쓰는 코

## 드나 아두이노 – 노드js – 웹 브라우저 간의 간략한 웹 소켓

### 통신 구조 코드도 이용

Q&A
