rupc/synthesizer/pics/슬라이드1.PNG

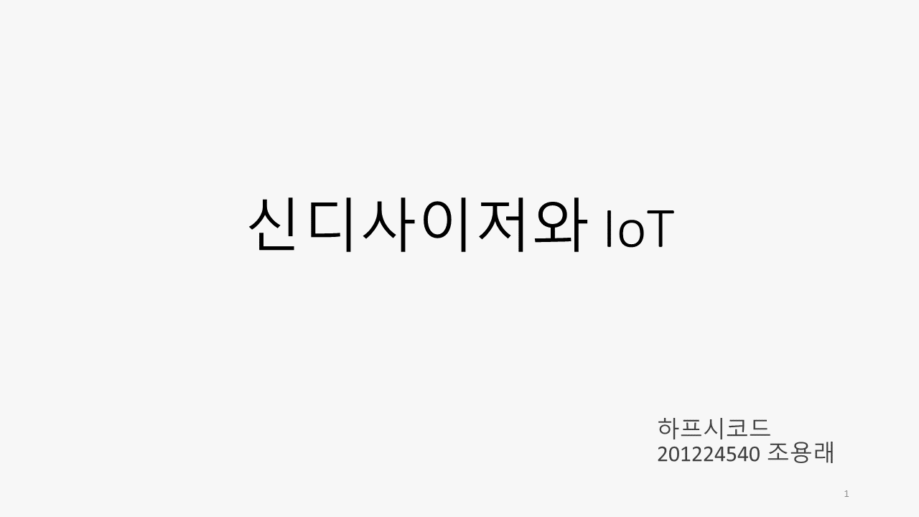
pics/슬라이드1.PNG
