rupc/synthesizer/pics/슬라이드2.PNG

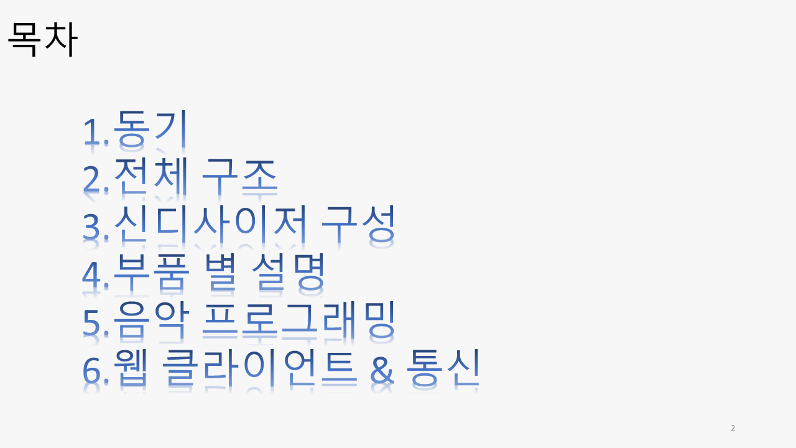
pics/슬라이드2.PNG
