rupc/synthesizer/pics/슬라이드6.PNG

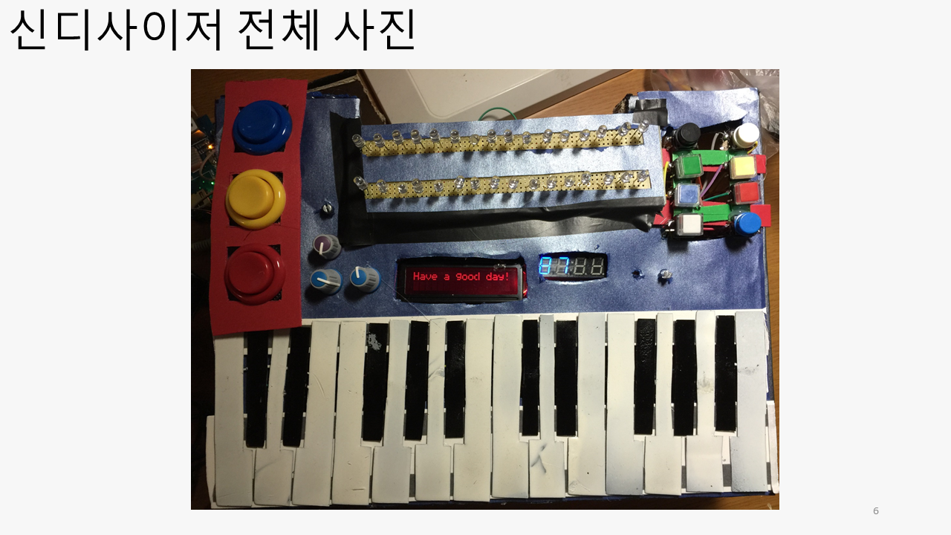
pics/슬라이드6.PNG
