rupc/synthesizer/pics/슬라이드7.PNG

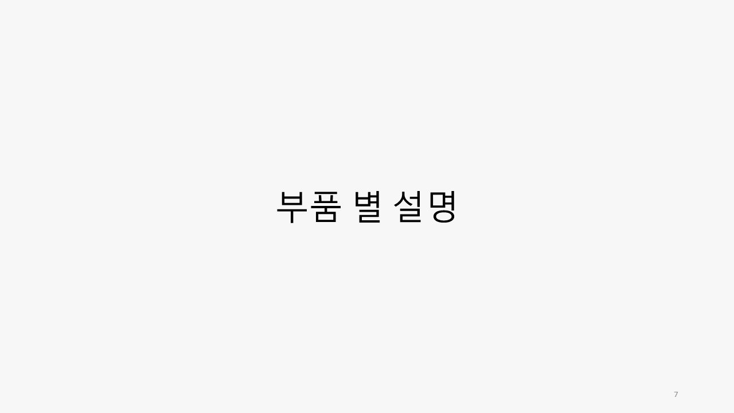
pics/슬라이드7.PNG
