rupc/synthesizer/pics/슬라이드8.PNG

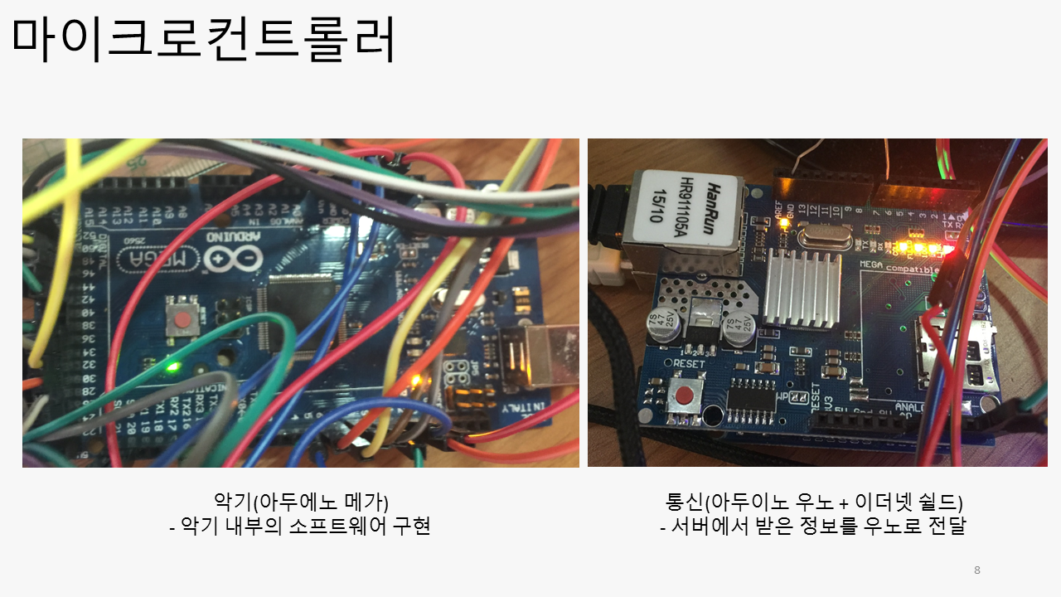
pics/슬라이드8.PNG
