rupc/synthesizer/pics/슬라이드30.PNG

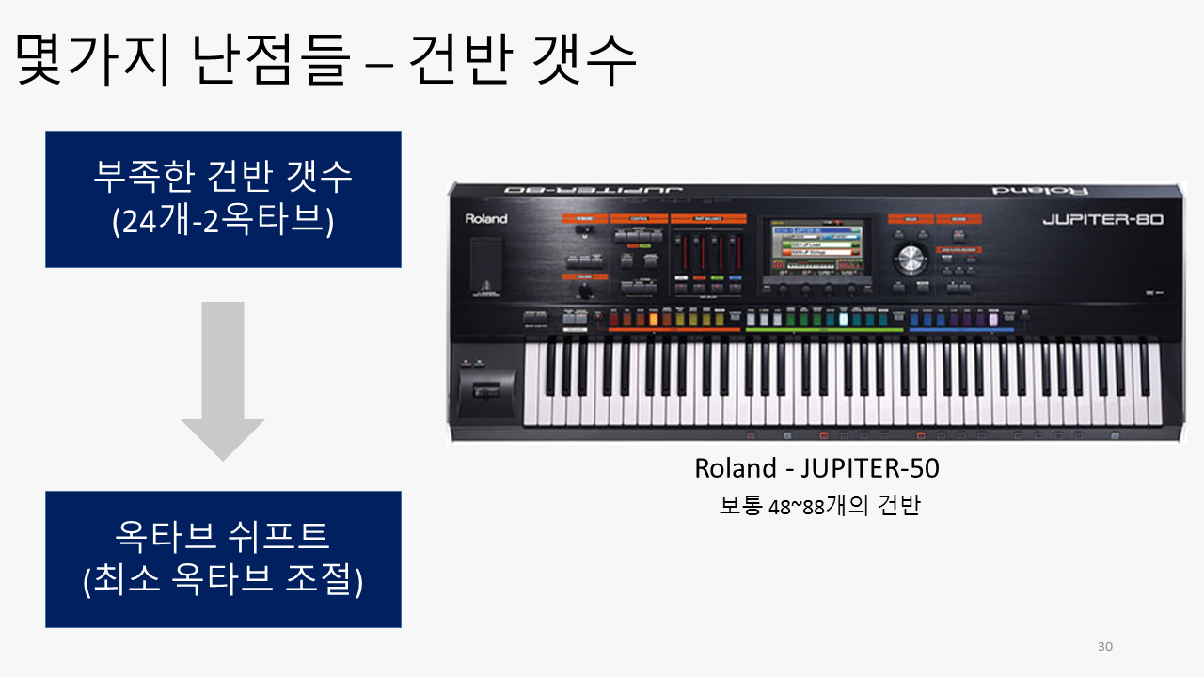
pics/슬라이드30.PNG
