rupc/synthesizer/pics/슬라이드31.PNG

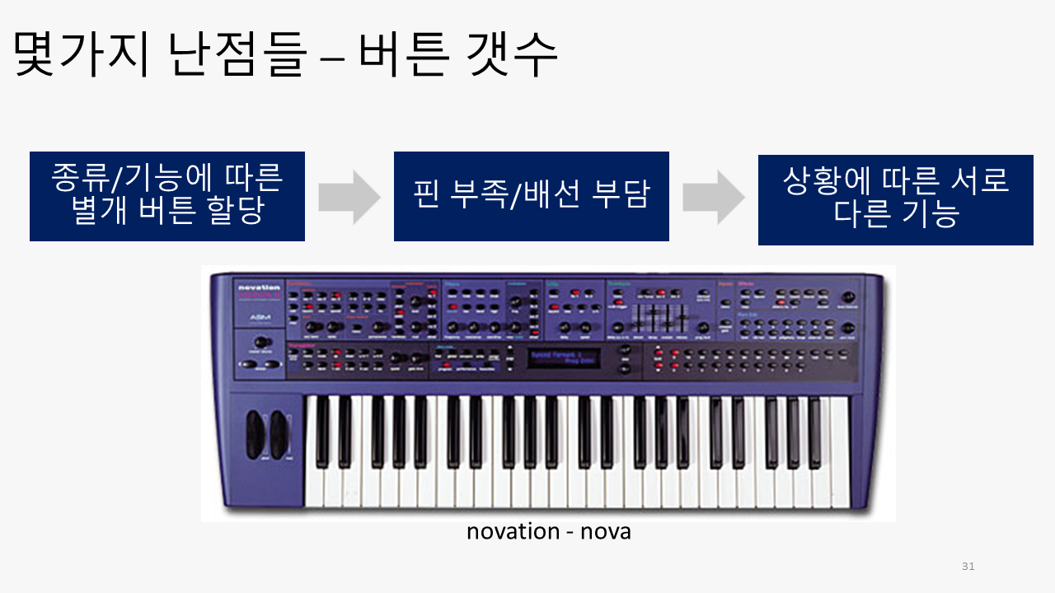
pics/슬라이드31.PNG
