rupc/synthesizer/pics/슬라이드32.PNG

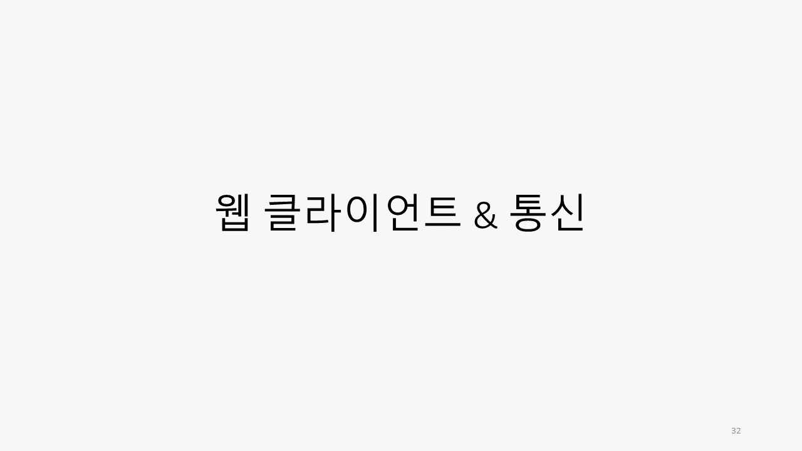
pics/슬라이드32.PNG
