rupc/synthesizer/pics/슬라이드33.PNG

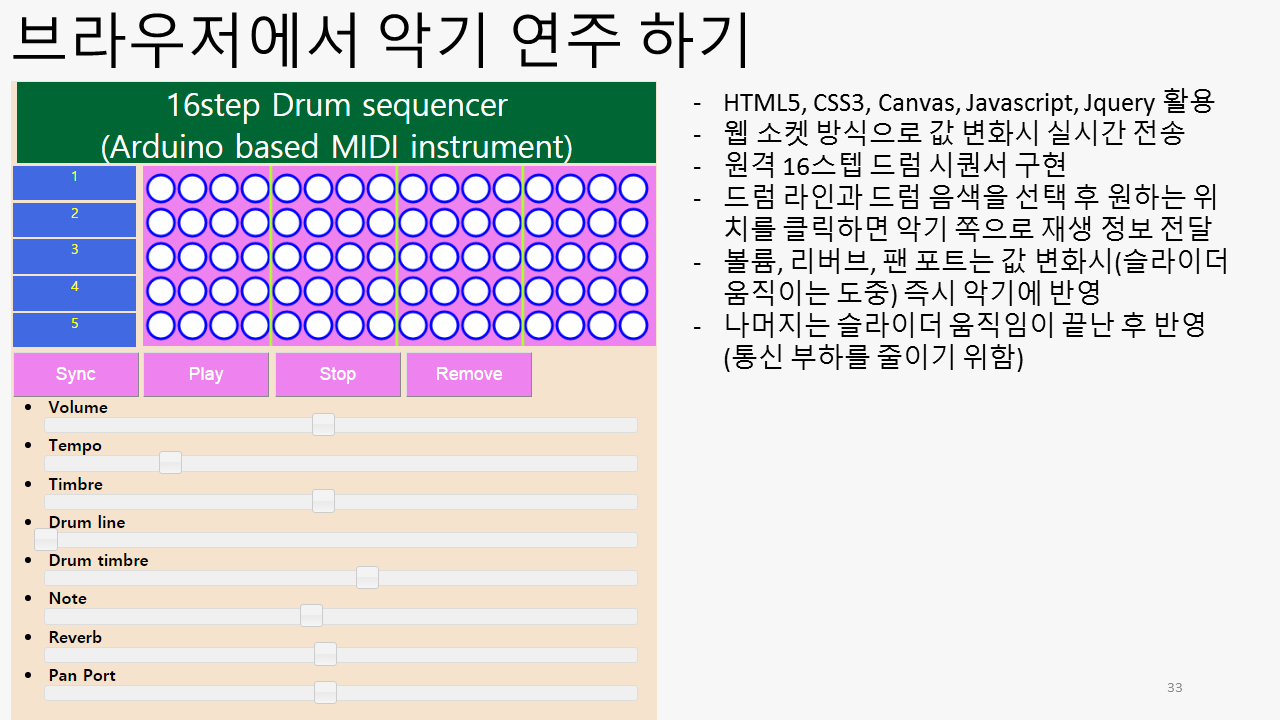
pics/슬라이드33.PNG
