rupc/synthesizer/pics/슬라이드35.PNG

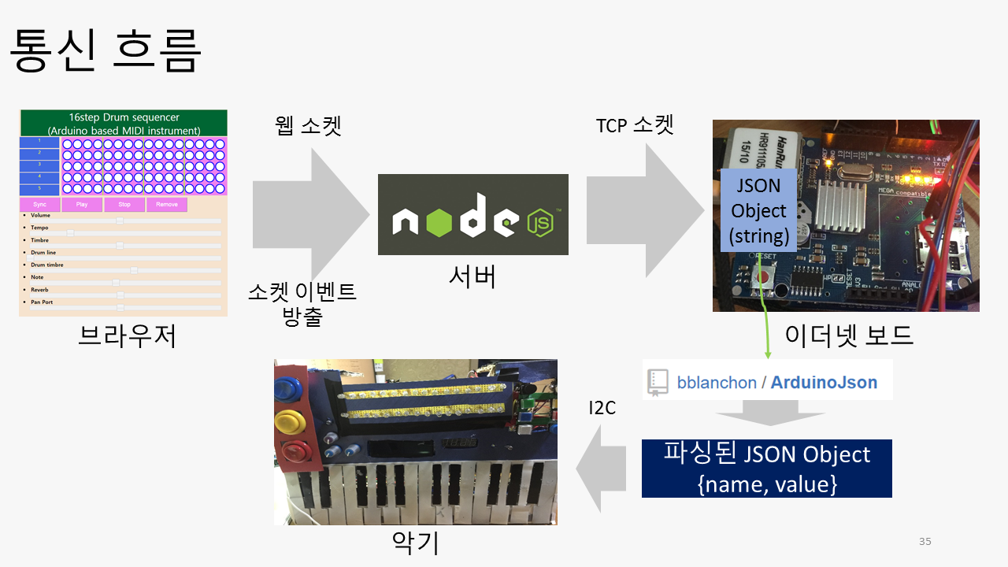
pics/슬라이드35.PNG
