rupc/synthesizer/pics/슬라이드36.PNG

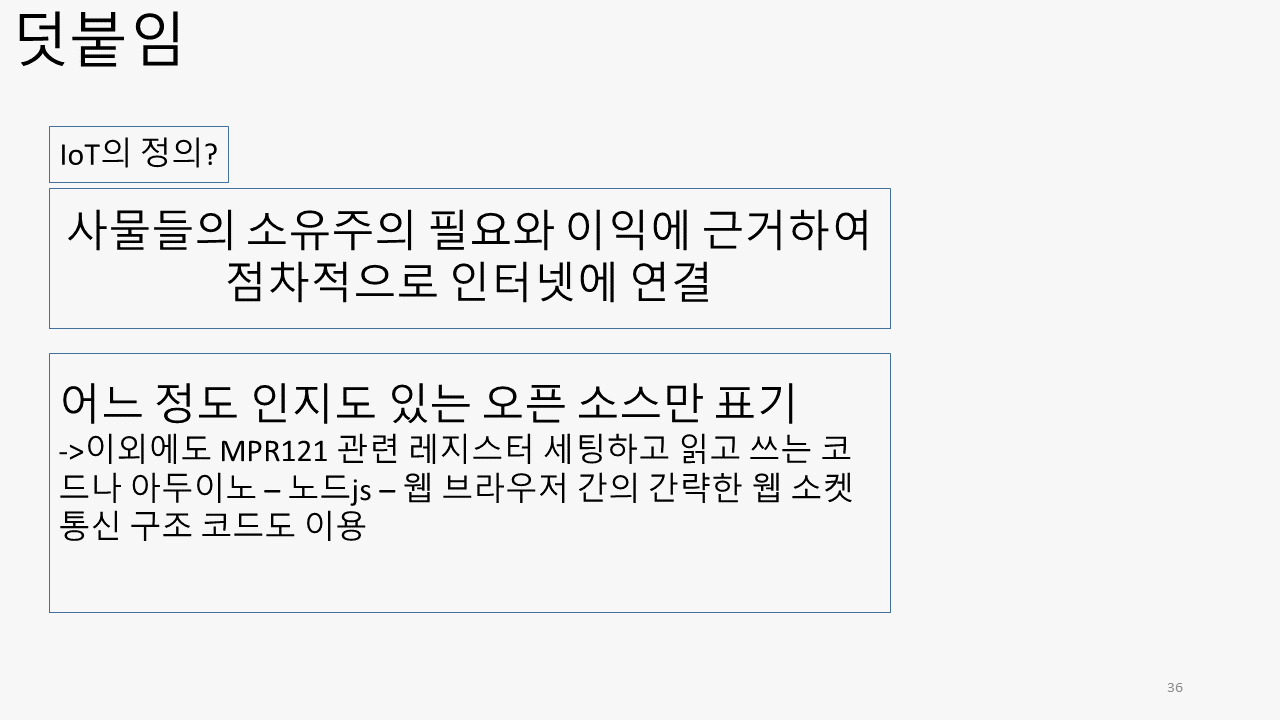
pics/슬라이드36.PNG
