rupc/synthesizer/server/tmp/note_off.png

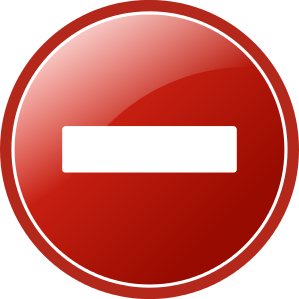
server/tmp/note_off.png
