rupc/synthesizer/server/tmp/penrosetile1.jpg

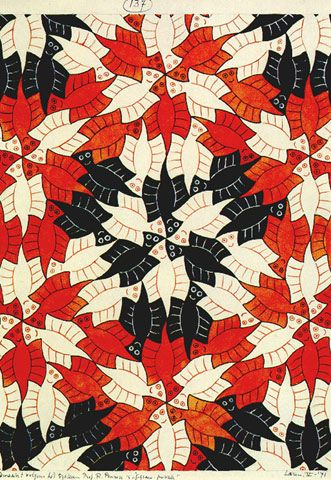
server/tmp/penrosetile1.jpg
