rupc/synthesizer/server/tmp/stop.jpg

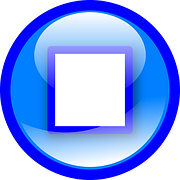
server/tmp/stop.jpg
