rupc/synthesizer/server/tmp/tstop.png

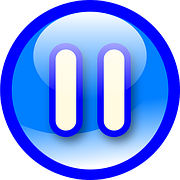
server/tmp/tstop.png
